VibrasticLab/pikoakustik2/README.md

# Pikoakustik V2

This is audiometri tool project (still in heavy development).
Main chip are STM32F4 and Audio-DAC MAX98357A.

If need previous works, see here: [Pikoakustik](https://github.com/VibrasticLab/pikoakustik)
