VibrasticLab/pikoakustik2/actual/P3_v2.md

# Catatan Desain

## Rekomendasi Revisi PCB P3
- STM32 tanpa resistor pull-up pada jalur SWD-IO
- STM32 USB-CDC pindah resistor pull-up dari jalur DM ke jalur DP
- ESP32 header programming cukup RX0, TX0, dan GND
- Cari pengganti Slot MMC yang serupa dan kompatibel
- STM32 USB-CDC ditambahkan ESD Protection
- STM32 RX (PA10) tidak boleh ada resistor pull-up
- STM32 MMC NSS tidak perlu ada resistor pull-up
- STM32 BOOT-0 dan BOOT-1 pake resistor pull-down
- STM32 tidak pakai (DNP) debouncing capacitor di tombol-tombol
- STM32 tambah header untuk UART
- Ada header terhubung ke
    + ESP32 TX1 -- STM32 RX1
    + ESP32 RX1 -- STM32 TX1
    + ESP32 GND -- STM32 GND
- Smaller Push-Button:
    + STM32 Reset
    + ESP32 Flash
    + ESP32 Reset
- Charging process status/indicator/detection
- ESP32 IO-12 should be low during boot via 0 ohm
- ESP32 IO-15 can be low to prevent boot message (pake dipswitch?)

## Rekomendasi Revisi Casing P3
- Tombol A/B/C masih bergoyang
- Panel LED akan menutup nyala LED jika matahari terang
- Topi tombol SPDT/Power tidak dapat dipasang
- Perlu 3D Print Medical Grade
