VibrasticLab/pikoakustik2/prototrial/dokumen/diskusi_xirca/diskusi_xirca.tex

\documentclass[table,dvipsnames]{beamer}
\mode<presentation>{
    \usetheme{Madrid}
    \setbeamercolor{title}{fg=Black,bg=Blue!15}
    \setbeamercolor{frametitle}{fg=Black,bg=Blue!15}
    \setbeamercolor{block title}{fg=Black,bg=Blue!15}
    \setbeamercolor{block}{fg=Black,bg=Blue!10}
}

\usepackage{hyperref}
\hypersetup{
    colorlinks=true,
    linkcolor=blue,
    filecolor=magenta,
    urlcolor=cyan,
}

\usepackage[normalem]{ulem}
\usepackage{graphicx}
\usepackage{booktabs}
\usepackage{xcolor}
\usepackage{multirow}
\usepackage{minted}
\usepackage[
type={CC},
modifier={by-sa},
version={4.0},
]{doclicense}

\definecolor{LightGray}{gray}{0.9}

\title[Xirca042022]{Activity Report: Xirca Februari 2023}
\author{}
\institute[VibrasticLab : \ccbysa]{
    Achmadi ST MT
}
\date{}

\begin{document}
    \begin{frame}
        \titlepage
    \end{frame}

    \section{Tempat dan Jadwal}
    \begin{frame}
        \begin{exampleblock}{Tempat dan Jadwal}
            Kegiatan berlangsung di:
            \begin{itemize}
                \item Tanggal: 6 Februari 2023 hingga 10 Februari 2023
                \item Pukul: 09:00 WIB hingga 17:00 WIB
                \item Tempat: Gedung Research and Development PT. Xirca Dama Persada\\
                Kompleks Puri Syailendra.\\
                Jl. Lemah Neundeut No. Kav-30, Sukawarna, Setrasari, Kota Bandung, Jawa Barat 40164 .
            \end{itemize}
        \end{exampleblock}
    \end{frame}

    \section{Pembahasan Revisi: Senin 6 Februari 2023}
    \begin{exampleblock}{Casing}
        Pembahasan casing untuk pengajuan BPFK:
        \begin{itemize}
            \item Wiggly/Uncomfortable Buttons
            \item Panel LED warna putih jadi problem ketika cahaya terang
            \item Tombol Power SPDT nya gak masuk
            \item Material kurang medical grade
        \end{itemize}
    \end{exampleblock}

    \begin{exampleblock}{Hasil Diskusi}

    \end{exampleblock}

    \section{Pembahasan Persiapan BPFK}
    \begin{exampleblock}{}

    \end{exampleblock}

\end{document}
