VibrasticLab/pikoakustik2/prototrial/dokumen/prototype_improvement/improve.tex

\documentclass{book} % Definisi jenis dokumen

%%%%% Definisi paket-paket yang seharusnya digunakan %%%%%
\usepackage[utf8]{inputenc} % paket encoding input utf8
\usepackage[T1]{fontenc} % paket encoding huruf latin
\usepackage{tocbibind} % paket toc terdaftar dalam toc

%%%%% Definisi paket-paket yang digunakan sesuai kebutuhan %%%%%
\usepackage[yyyymmdd,hhmmss]{datetime} % paket tanggal-waktu
\usepackage{geometry} % paket ukuran kertas dan margin
\usepackage{graphicx} % paket grafik/gambar
\usepackage{subcaption} % paket untuk subfigure
\usepackage{minted} % paket untuk source code
\usepackage{xcolor} % paket buat warna
\usepackage{hyperref} % paket buat link-link an

%%%%% Pengaturan ukuran kertas dan margin %%%%%
\geometry{
    a4paper,
    left=10mm,
    right=10mm,
    top=15mm,
    bottom=15mm,
}

%%%%% Pengaturan perintah informasi perangkat lunak (hanya untuk GNU/Linux) %%%%%
\newcommand{\ShowOsVersion}{
    \immediate\write18{\unexpanded{foo=`uname -sro` && echo "${foo}" > tmp.tex}}
    \input{tmp}\immediate\write18{rm tmp.tex}
}

\newcommand{\ShowTexVersion}{
    \immediate\write18{\unexpanded{foo=`pdflatex -version | head -n1 | cut -d' ' -f1,2` && echo "${foo}" > tmp.tex}}
    \input{tmp}\immediate\write18{rm tmp.tex}
}

\definecolor{LightGray}{gray}{0.95}

\begin{document}

    %%%%%%%%%%%%%%%%%%%%%%%%%%%%%%%%%%%%%%%%%%%%%%%%%%%%%%%%%%%%%%%%%

    \frontmatter % untuk halaman cover

    \begin{titlepage}

        \centering % untuk membuat tengah teks

        {
            \LARGE % pakai font besar
            \bf % pakai font BOLD
            Rangkuman Improvement Prototype P2 dan P3
        }

        \bigskip
        {\Large \bf Achmadi ST MT}
        \vfill % menambahkan ruang kosong vertikal

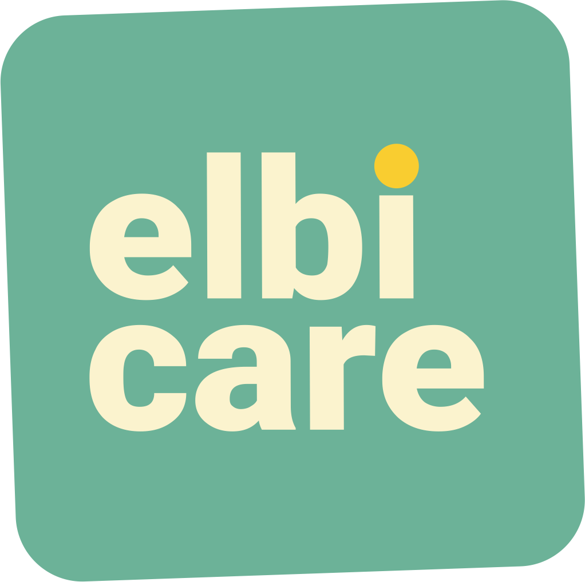
[picture p50: prototrial/dokumen/prototype_improvement/images/elbicare-logo.png]
        
        \vfill

        \raggedright
        \noindent Dokumen ini ditulis dengan:\\ % tanda \\ menambahkan garis baru
        OS : \ShowOsVersion \\
        TeX : \ShowTexVersion \\
        Update: {\today} at \currenttime\\
    \end{titlepage}

	%%%%%%%%%%%%%%%%%%%%%%%%%%%%%%%%%%%%%%%%%%%%%%%%%%%%%%%%%%%%%%%%%
	
	\newpage % halaman baru
	\tableofcontents % daftar isi
	\listoffigures % daftar gambar
	\listoftables % daftar table

    %%%%%%%%%%%%%%%%%%%%%%%%%%%%%%%%%%%%%%%%%%%%%%%%%%%%%%%%%%%%%%%%%
    
    \mainmatter % pindah format halaman dari romawi ke angka (konten utama)
    
    \newpage
    \chapter{Definisi}
    
    Berikut beberapa definisi umum yang digunakan dalam dokumen ini:
    
    \begin{enumerate}
    	\item \textbf{P2}: Mengacu pada desain Prototype Versi 2 yang 
    	dikembangkan selama awal tahun 2021 sebagai acuan awal desain produk
    	
    	\begin{figure}[!ht]
    		\centering
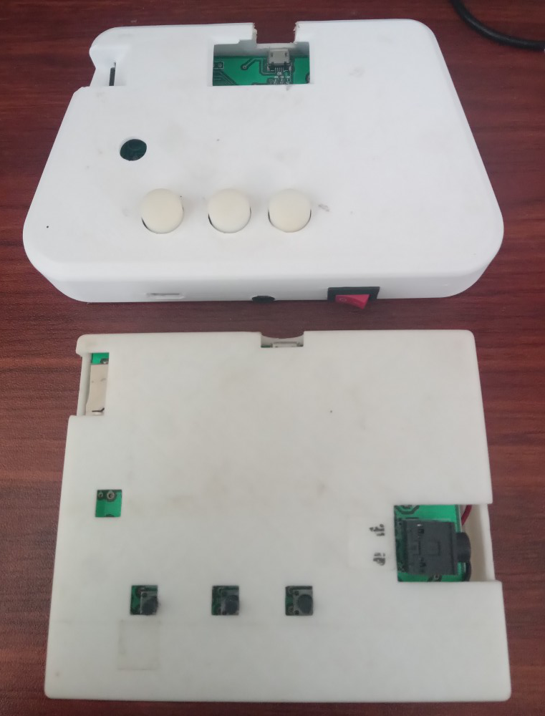
[picture p51: prototrial/dokumen/prototype_improvement/images/p2.jpg]
    		
    		\caption{Gambaran Unit P2 (kanan) dan Unit P2 dengan improvisasi 
    		casing (kiri)}
    	\end{figure}
    
    	\item \textbf{P3}: Mengacu pada desain Prototype Versi 3 yang 
    	dikembangkan sejak akhir tahun 2021 sebagai desain produk siap produksi 
    	massal
    	
    	\begin{figure}[!ht]
    		\centering
    		
    		\caption{Gambaran Unit P3}
    	\end{figure}
    \end{enumerate}
    
    \newpage
    \chapter{Circuit}
    
    Berikut dirangkum perbaikan produk di aspek desain sirkuit elektronik 
    tercetak (PCB), yang dibagi dalam grup-grup komponen.
    
    \section{STM32}
    
    Untuk penggunaan chip utama Audiometri, yaitu STM32 ARM Cortex-M4, tidak 
    mengalami perubahan jauh.
    
    \begin{figure}[!ht]
    	\centering
    	\begin{subfigure}[t]{0.25\textwidth}
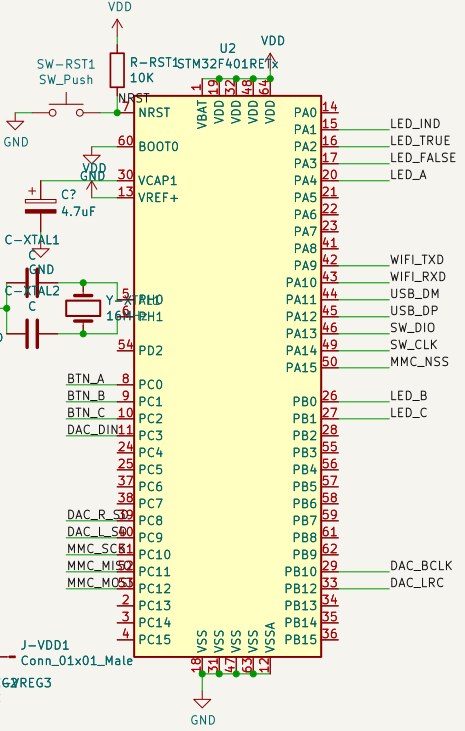
[picture p52: prototrial/dokumen/prototype_improvement/images/p2_stm32.png]
    		
    		\caption{STM32 pada P2}
    	\end{subfigure}
    	\begin{subfigure}[t]{0.40\textwidth}
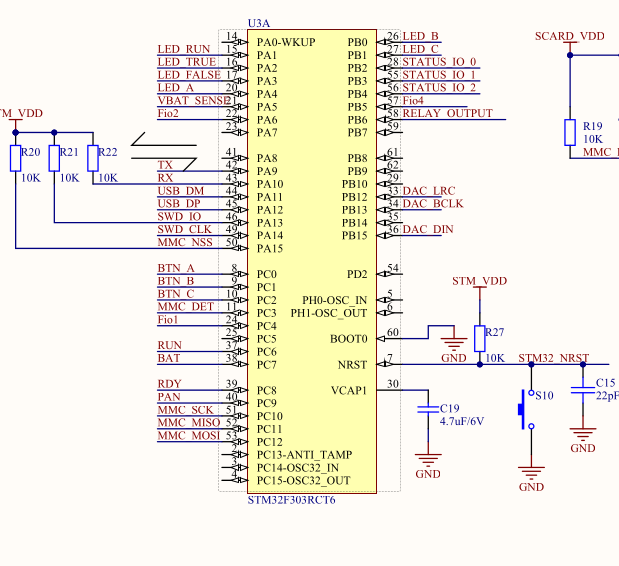
[picture p53: prototrial/dokumen/prototype_improvement/images/p3_stm32.png]
    		
    		\caption{STM32 pada P3}
    	\end{subfigure}
    	\caption{STM32 sebagai chip Audiometri}
    \end{figure}

	Beberapa poin rangkuman perbaikan:
	\begin{itemize}
		\item Kompatibel dengan chip STM32 ARM Cortex-M4 untuk paket LQFP64.
		Chip yang telah digunakan adalah STM32F401RET6 dan STM32F303RBT6
		
		\item External RC/Crystal source dihapus
		
		\item Tambahan pull-up resistor pada beberapa pin.
		Beberapa catatan terkait pull-up resistor untuk desain selanjutnya:
		\begin{itemize}
			\item SWD-IO tidak boleh ada pull-up
			\item Pull pada USB-DM harus dipindah ke USB-DP
		\end{itemize}
	\end{itemize}

	Chip STM32 Cortex-M4 ini yang menangani proses \textit{3-Force Choice} (3FC) ,
	pembuatan sinyal PCM untuk nada murni, serta olah data hasil Audiometri via USB-Serial.
    
    \section{ESP32}
    
    Penambahan modul ESP32 (ESP-WROOM-32) adalah fitur baru yang sebelumnya 
    tidak ada pada P2.
    Modul ini ditambahkan sebagai penunjang antar muka pengguna dalam penggunaan 
    Audiometri yang ditangani oleh chip STM32
    
    \begin{figure}[!ht]
    	\centering
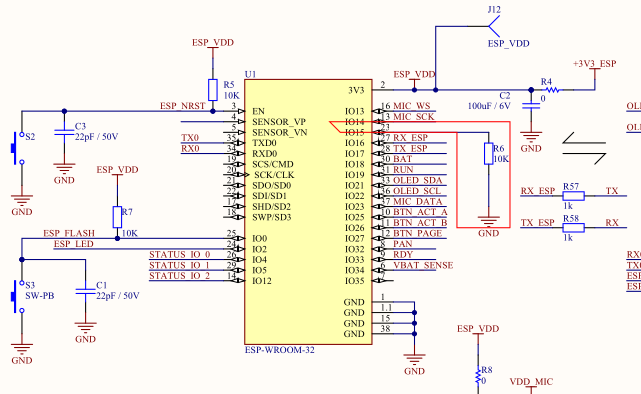
[picture p54: prototrial/dokumen/prototype_improvement/images/p3_esp32.png]
    	
    	\caption{Modul ESP32 pada P3}
    \end{figure}
	
	\newpage
	Fitur yang akan ditangani oleh modul ESP32 meliputi:
	\begin{itemize}
		\item \textit{Drawing} untuk tampilan layar dan data ke pengguna
		\item Komunikasi data dengan server untuk wadah data pengguna via WiFi Station
		\item Pengaturan unit via WiFi Access Point
		\item Memantau besar derau audio lingkungan
		\item Memantau status fitur-fitur pada unit
	\end{itemize}
    
    \section{Power}
    
    Untuk bagian pengaturan daya, telah mengalami perbaikan sangat signifikan sehingga desain P3 menjadi lebih stabil.
    
    \begin{figure}[!ht]
    	\centering
    	\begin{subfigure}[t]{0.25\textwidth}
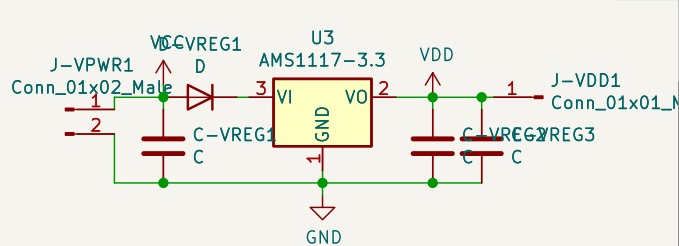
[picture p55: prototrial/dokumen/prototype_improvement/images/p2_vreg.png]
    		
    		\caption{Power Regulator pada P2}
    	\end{subfigure}
    	\begin{subfigure}[t]{0.40\textwidth}
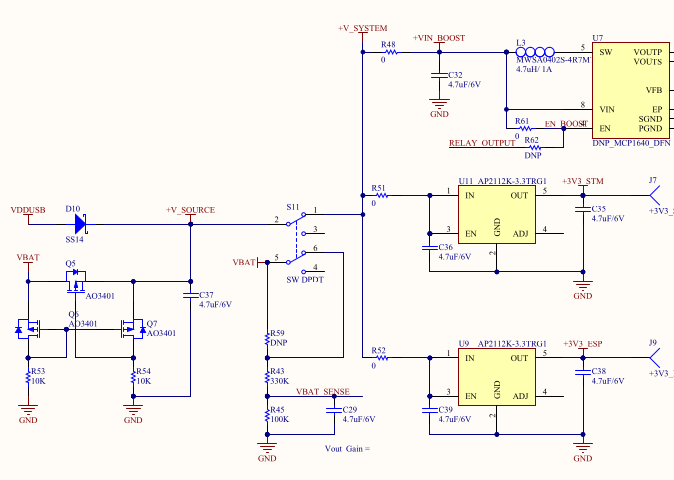
[picture p56: prototrial/dokumen/prototype_improvement/images/p3_vreg.png]
    		
    		\caption{Power Regulator pada P3}
    	\end{subfigure}
    	\caption{Power Regulator}
    \end{figure}

	Beberapa poin rangkuman perbaikan antara lain:
	\begin{itemize}
		\item Regulator utama diganti dari berbasis AMS1117 LDO 3v3 menjadi AP2112K 3v3.
		\item Pemisahan regulator daya menjadi beberapa grup sesuai kebutuhan
	\end{itemize}
    
    \section{Audio DAC}
    
    Untuk bagian Audio yang menghasilkan nada murni, chip yang digunakan tetap MAX98357A.
    Namun mendapat perubahan desain terkait pengaturan channel kiri dan kanan.
    
    \begin{figure}[!ht]
    	\centering
    	\begin{subfigure}[t]{0.25\textwidth}
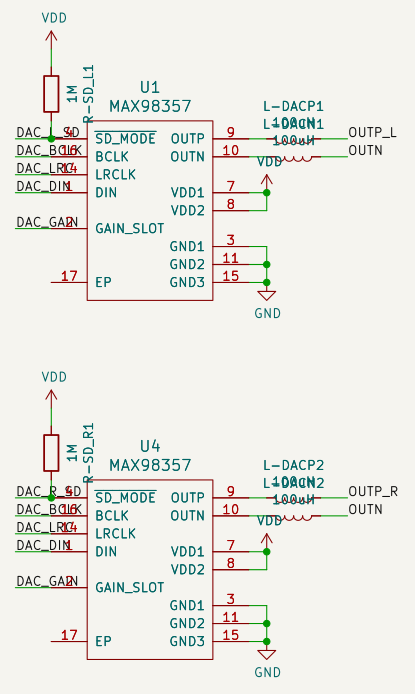
[picture p57: prototrial/dokumen/prototype_improvement/images/p2_dac.png]
    		
    		\caption{Audio DAC pada P2}
    	\end{subfigure}
    	\begin{subfigure}[t]{0.60\textwidth}
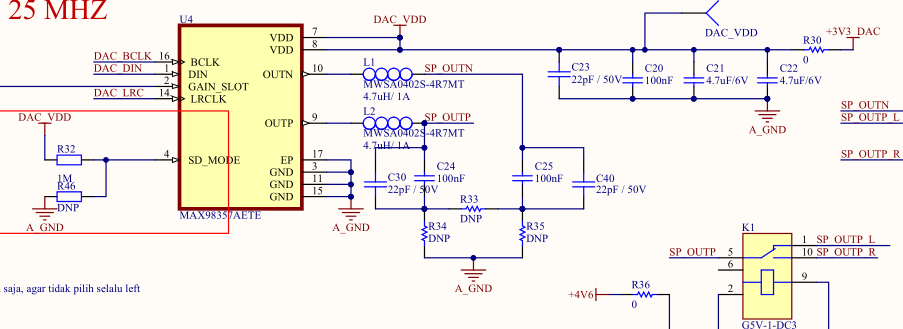
[picture p58: prototrial/dokumen/prototype_improvement/images/p3_dac.png]
    		
    		\caption{Audio DAC pada P3}
    	\end{subfigure}
    	\caption{Audio DAC}
    \end{figure}

	Beberapa poin rangkuman perbaikan antara lain:
	\begin{itemize}
		\item Audio DAC menggunakan relay sebagai pemisah channel, bukan lagi 2 chip tersendiri
		\item Tambahan banyak decoupling capacitor dan filter pada output
		\item Mendapat regulator tenaga tersendiri (terpisah dengan chip/modul utama lain)
	\end{itemize}
    
    \section{Display}
    
    P3 mendapat fitur baru berupa OLED LCD untuk membantu pengguna.
    OLED LCD yang digunakan berupa 128x64 LCD yang terhubung ke modul ESP32 melalui jalur I2C.
    
    \begin{figure}[!ht]
    	\centering
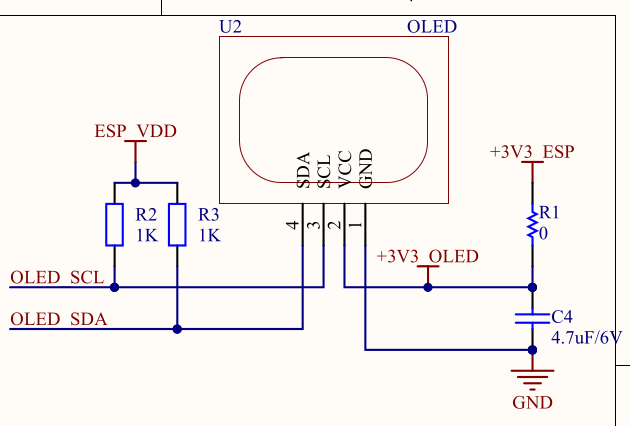
[picture p59: prototrial/dokumen/prototype_improvement/images/p3_oled.png]
    	
    	\caption{Modul OLED LCD}
    \end{figure}
    
    \newpage
    \section{Storage}
    
    Untuk penyimpanan hasil Audiometri, baik P2 dan P3 sama-sama menggunakan MicroSD yang
    terhubung dengan STM32 melalui jalur SPI.
    
    \begin{figure}[!ht]
    	\centering
    	\begin{subfigure}[t]{0.25\textwidth}
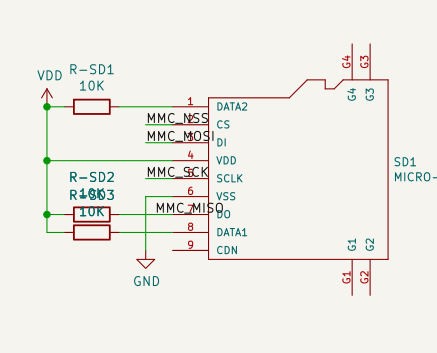
[picture p60: prototrial/dokumen/prototype_improvement/images/p2_mmc.png]
    		
    		\caption{MMC pada P2}
    	\end{subfigure}
    	\begin{subfigure}[t]{0.60\textwidth}
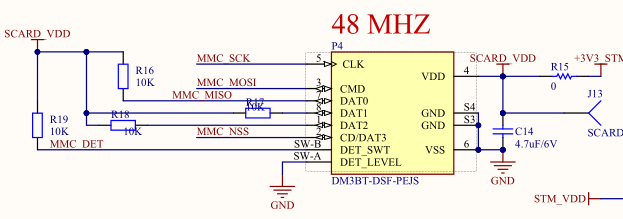
[picture p61: prototrial/dokumen/prototype_improvement/images/p3_mmc.png]
    		
    		\caption{MMC pada P3}
    	\end{subfigure}
    	\caption{Slot MMC}
    \end{figure}

	Beberapa poin rangkuman perbaikan antara lain:
	\begin{itemize}
		\item Slot diganti ke pinout kompatibel DM3BT.
		\item Pin deteksi diaktifkan dengan tambahan pull-up resistor.
	\end{itemize}

	Catatan: Diperlukan beberapa purchasing komponen slot MMC yang kompatibel DM3BT.
    
    \section{USB-Data}
    
    Untuk USB-CDC sebagai antar-muka data, tidak mengalami banyak perubahan.
    USB-CDC tetap terhubung ke pin USB dari STM32.
    
    \begin{figure}[!ht]
    	\centering
    	\begin{subfigure}[t]{0.4\textwidth}
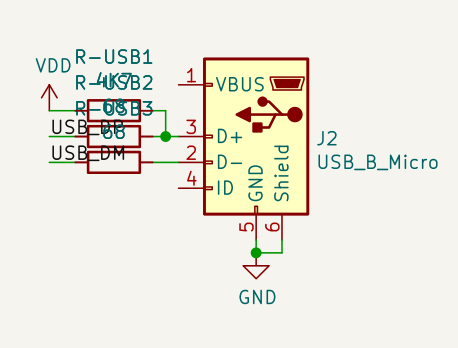
[picture p62: prototrial/dokumen/prototype_improvement/images/p2_usb.png]
    		
    		\caption{USB-CDC pada P2}
    	\end{subfigure}
    	\begin{subfigure}[t]{0.4\textwidth}
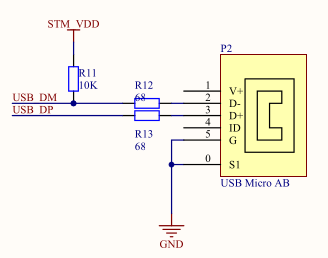
[picture p63: prototrial/dokumen/prototype_improvement/images/p3_usb.png]
    		
    		\caption{USB-CDC pada P3}
    	\end{subfigure}
    	\caption{USB-CDC}
    \end{figure}

	Catatan: Disarankan ditambahkan USB ESD Protection.
    
    \newpage
    \section{Microphone}
    
    Untuk P3, ditambahkan fitur Microphone berbasis INMP441 yang terhubung ke ESP32 melalui jalur I2S.
    Microphone ini akan digunakan untuk membantu memantau derau lingkungan saat proses Audiometri.
    
    \begin{figure}[!ht]
    	\centering
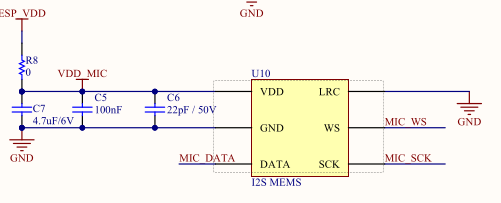
[picture p64: prototrial/dokumen/prototype_improvement/images/p3_mic.png]
    	
    	\caption{Microphone}
    \end{figure}
    
    \chapter{Casing}
    
    Untuk bagian Casing, berikut penjabaran singkat perbandingan casing antara unit P2 dan P3
    Secara umum, casing P2 lebih sederhana dan tidak memiliki antara muka tombol user dan LCD OLED.
    Bentuk casing masih balok sederhana yang hanya "menyelimuti" PCB dan battery.
    
    \begin{figure}[!ht]
    	\centering
    	\begin{subfigure}[t]{0.45\textwidth}
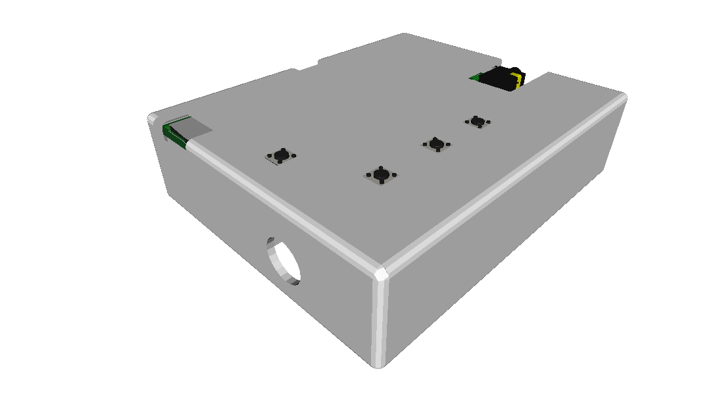
[picture p65: prototrial/dokumen/prototype_improvement/images/p2_ortho_top.png]
    		
    		\caption{Tampilan Orthogonal Atas}
    	\end{subfigure}
    	\begin{subfigure}[t]{0.45\textwidth}
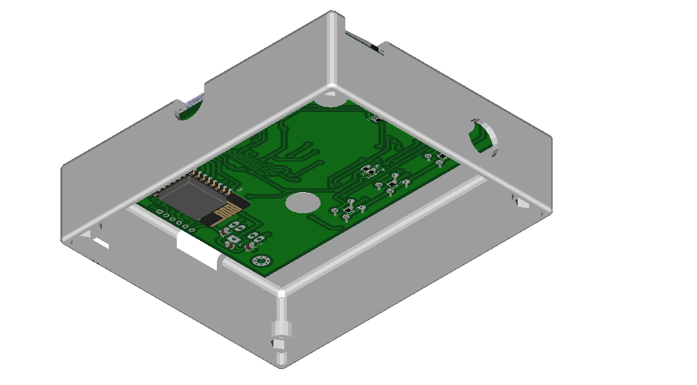
[picture p66: prototrial/dokumen/prototype_improvement/images/p2_ortho_bot.png]
    		
    		\caption{Tampilan Orthogonal Bawah}
    	\end{subfigure}
    	\caption{Tampilan Casing P2}
    \end{figure}

	\begin{figure}[!ht]
		\centering
		\begin{subfigure}[t]{0.45\textwidth}
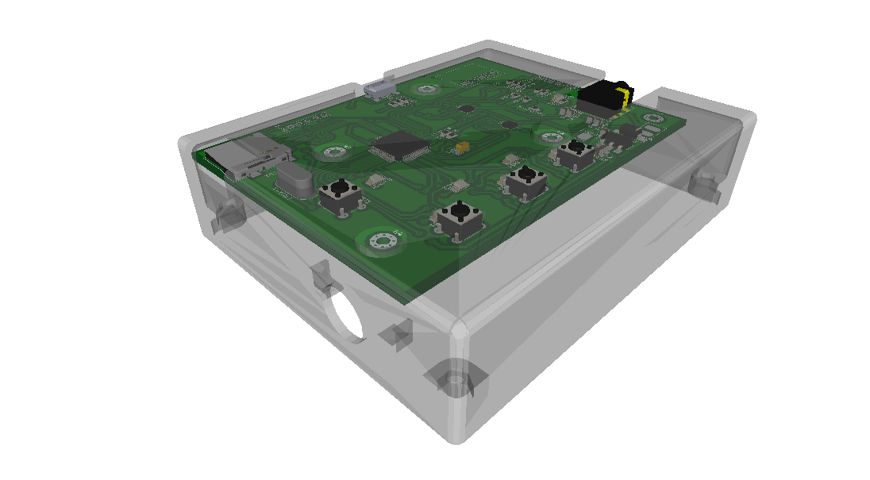
[picture p67: prototrial/dokumen/prototype_improvement/images/p2_ortho_top_trans.png]
			
			\caption{Tampilan Orthogonal Atas}
		\end{subfigure}
		\begin{subfigure}[t]{0.45\textwidth}
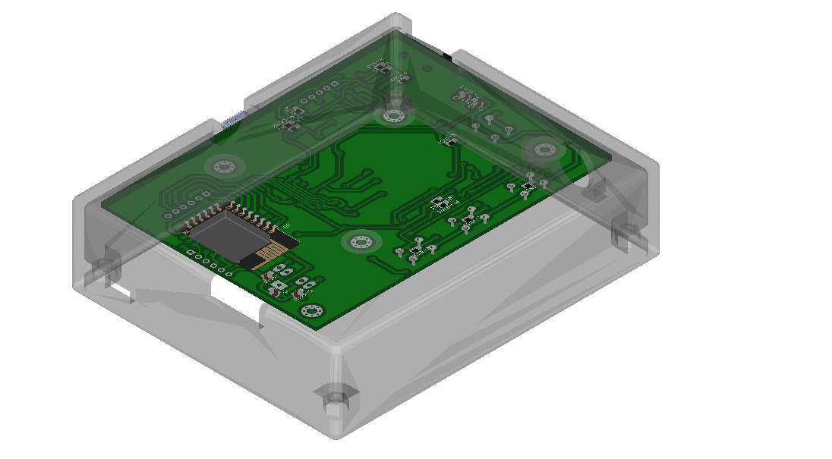
[picture p68: prototrial/dokumen/prototype_improvement/images/p2_ortho_bot_trans.png]
			
			\caption{Tampilan Orthogonal Bawah}
		\end{subfigure}
		\caption{Tampilan Casing P2 dengan tampak PCB}
	\end{figure}

	Untuk casing P3 telah mendapat improvisasi signifikan, antara lain:
	\begin{itemize}
		\item Outline PCB didesain menyesuaikan outline casing, sehingga dapat lebih pas.
		
		\item Port Audio, USB, dan MMC dipindahkan ke atas dan bawah, sehingga sisa kanan dan kiri
		dapat sepenuhnya untuk telapak tangan.
		
		\item Tambahan slot untuk tombol user dan layar LCD OLED.
		
		\item Kontur fisik casing mengikuti ergonomi (tidak berupa balok sederhana)
	\end{itemize}

	\newpage
	Berikut tampilan casing P3
	
	\begin{figure}[!ht]
		\centering
		\begin{subfigure}[t]{0.45\textwidth}
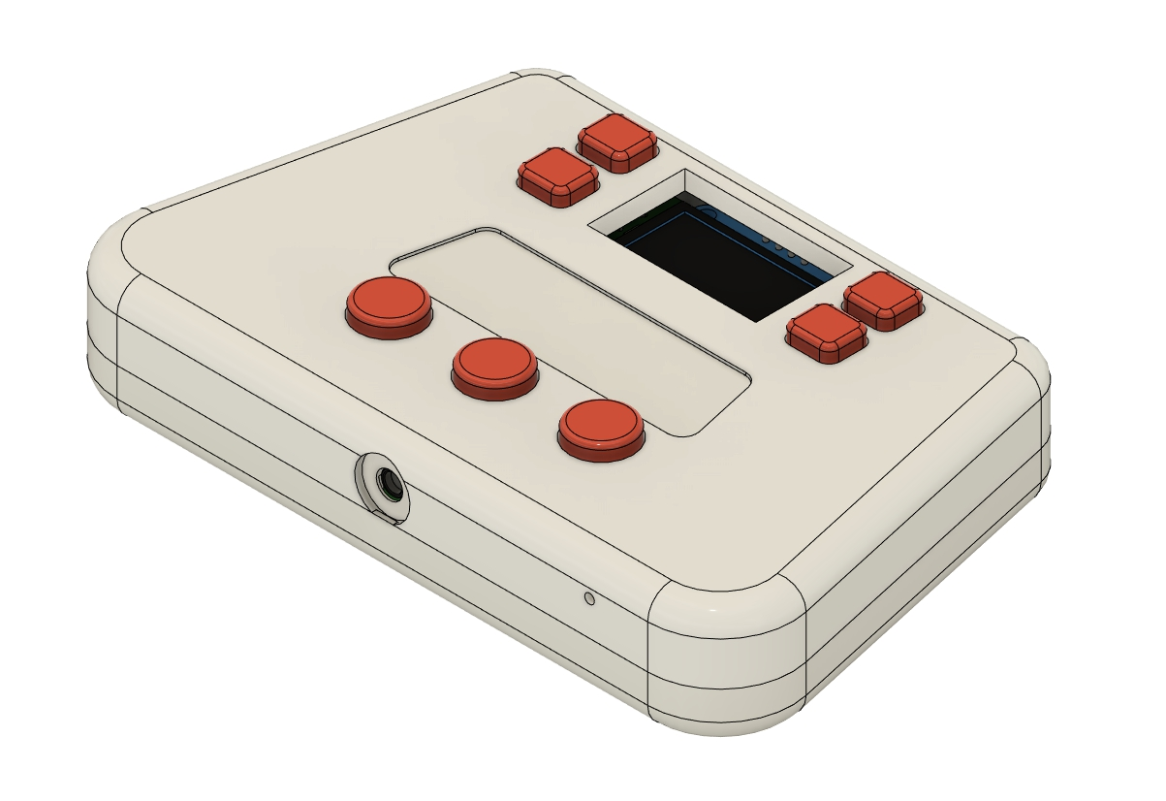
[picture p69: prototrial/dokumen/prototype_improvement/images/p3_casing_outline.png]
			
			\caption{Tampilan Outline}
		\end{subfigure}
		\begin{subfigure}[t]{0.45\textwidth}
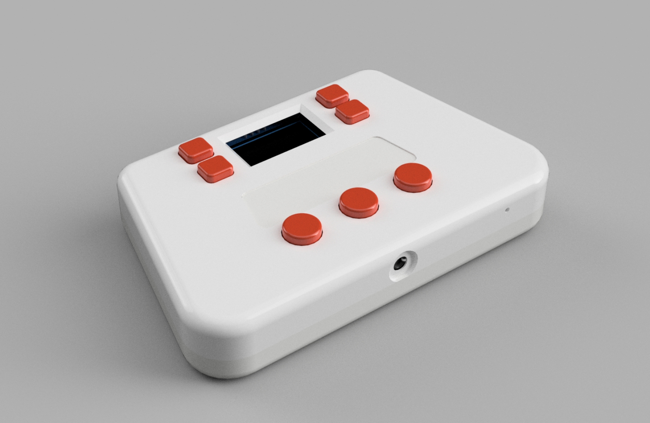
[picture p70: prototrial/dokumen/prototype_improvement/images/p3_casing.png]
			
			\caption{Tampilan 3D}
		\end{subfigure}
		\caption{Tampilan Casing P3}
	\end{figure}

	\begin{figure}[!ht]
		\centering
		\begin{subfigure}[t]{0.45\textwidth}
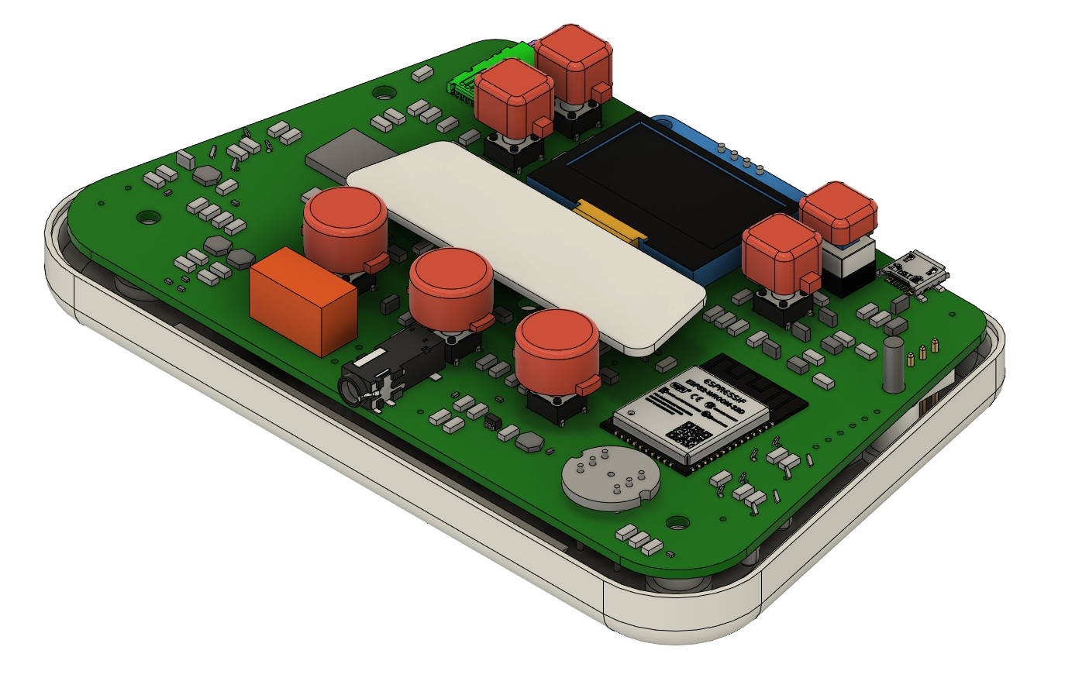
[picture p71: prototrial/dokumen/prototype_improvement/images/p3_casing_pcb.png]
			
			\caption{Tampilan Outline dengan PCB}
		\end{subfigure}
		\begin{subfigure}[t]{0.45\textwidth}
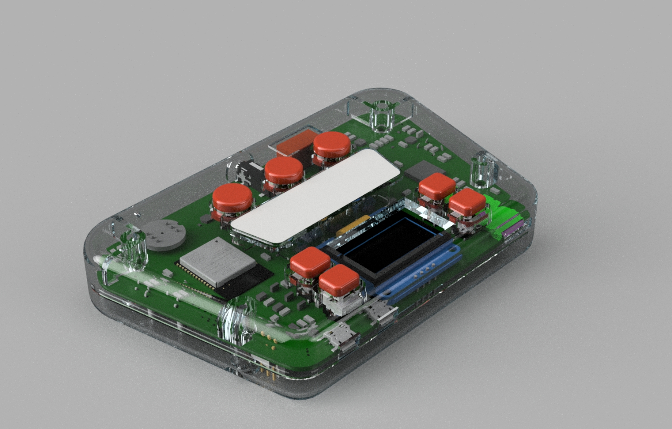
[picture p72: prototrial/dokumen/prototype_improvement/images/p3_casing_trans.png]
			
			\caption{Tampilan 3D dengan PCB}
		\end{subfigure}
		\caption{Tampilan Casing P3 dan PCB}
	\end{figure}
    
    \chapter{Firmware}
    
    Berikut dijabarkan singkat beberapa upgrade esensial pada programm di dalam chip (firmware).
    
    \section{Komunikasi chip STM32 dan ESP32}
    
    Berikut potongan kode yang membangun komunikasi antar chip:
    
    \begin{minted}[frame=lines,framesep=2mm,fontsize=\small,bgcolor=LightGray]{c}
#if USER_ESP32
static void cmd_esp(BaseSequentialStream *chp, int argc, char *argv[]) {
	if(argc!=1){
		chprintf(chp,"Usage: esp [wifi]\r\n");
		return;
	}
	
	if(strcmp(argv[0],"wifi")==0){
		ht_commUSB_Msg("wifi 1\r\n");
		ht_commUART_Msg("wifi 1\r\n");
	}
	
}
#endif
    \end{minted}

	Catatan commit dapat dilihat pada tautan berikut: \\
	\url{https://github.com/VibrasticLab/pikoakustik2/commit/1fb3d2bbe1bf70bc83f9fc04626da6788534853a}
	
	\section{Status GPIO}
	
	Berikut potongan kode dimana chip ESP32 mengawasi status STM32 melalui nilai logika pin.
	
	\begin{minted}[frame=lines,framesep=2mm,fontsize=\small,bgcolor=LightGray]{c}
#define PIN_STMSTT_READY	33

#define IO_STMSTT_IN ((1ULL<<PIN_STMSTT_READY))

extern uint8_t runIdle;

static void stm32statusTask(void *pvParameter){
	while (1) {
		vTaskDelay(100 / portTICK_PERIOD_MS);
		
		if(gpio_get_level(PIN_STMSTT_READY)==1)runIdle=HT_STATE_IDLE;
		else if(gpio_get_level(PIN_STMSTT_READY)==0)runIdle=HT_STATE_PREP;
	}
}

void msg_htiosttInit(void){
	gpio_config_t stm32iostt_conf;
	
	stm32iostt_conf.intr_type = GPIO_INTR_DISABLE;
	stm32iostt_conf.mode = GPIO_MODE_INPUT;
	stm32iostt_conf.pin_bit_mask = IO_STMSTT_IN;
	stm32iostt_conf.pull_down_en = GPIO_PULLDOWN_ENABLE;
	stm32iostt_conf.pull_up_en = GPIO_PULLUP_DISABLE;
	gpio_config(&stm32iostt_conf);
	
	xTaskCreate(&stm32statusTask, "stm32status_task", 1024, NULL, tskIDLE_PRIORITY, NULL);
}
	\end{minted}

	Catatan commit dapat dilihat pada tautan berikut: \\
	\url{https://github.com/VibrasticLab/pikoakustik2/commit/ea8ad4c23ea734fd0c6e4667258446635624f307}
	
	\section{ESP32 HTTPD}
	
	Disediakan WIFI server untuk membantu pengguna melakukan pengaturan dan operasi unit untuk
	proses yang tidak berkaitan dengan sesi Audiometri langsung
	
	\begin{minted}[frame=lines,framesep=2mm,fontsize=\small,bgcolor=LightGray]{c}
static httpd_handle_t start_webserver(void){
	httpd_handle_t server = NULL;
	httpd_config_t config = HTTPD_DEFAULT_CONFIG();
	config.lru_purge_enable = true;
	
	ESP_LOGI(TAG,"Starting server on port: %d",config.server_port);
	if(httpd_start(&server,&config)==ESP_OK){
		ESP_LOGI(TAG, "Register URI handlers");
		httpd_register_uri_handler(server,&hello);
		return server;
	}
	
	ESP_LOGI(TAG, "Server start error");
	return NULL;
}
	\end{minted}

	Catatan commit dapat dilihat pada tautan berikut: \\
	\url{https://github.com/VibrasticLab/pikoakustik2/commit/0610ab66aaa5b126126c506176e9d01e94bd3d4f}

	\section{Pengawas Battery}
	
	ESP32 melaksanakan tugas pengawasan muatan battery dengan memantau nilai tegangan battery melalui fitur ADC
	yang dimiliki.
	
	\begin{minted}[frame=lines,framesep=2mm,fontsize=\small,bgcolor=LightGray]{c}
void my_adcGetBatt(void){
	int adcVolt;
	int adcVoltRange;
	
	adc_raw[0][0] = adc1_get_raw(ADC1_EXAMPLE_CHAN0);
	battPercent = adc_raw[0][0] * 100 / ADC_REFF_VAL;
	if((adc_raw[0][0]>=ADC_BATT_EMTY) && (adc_raw[0][0]<ADC_BATT_FULL)){
		adcVolt = adc_raw[0][0] - ADC_BATT_EMTY;
		adcVoltRange = ADC_BATT_FULL - ADC_BATT_EMTY;
		battPercent = adcVolt * 100 / adcVoltRange;
	}
	else{
		if(adc_raw[0][0]>=ADC_BATT_FULL) battPercent = 100;
		if(adc_raw[0][0]<ADC_BATT_EMTY) battPercent = 0;
	}
}
	\end{minted}

	Catatan commit dapat dilihat pada tautan berikut: \\
	\url{https://github.com/VibrasticLab/pikoakustik2/commit/43d9589735e2824f7ac6ef5610cf95006735dce6}

\end{document}
