VibrasticLab/pikoakustik2/prototrial/firmware/esp8266/main/oled_urls.md

# ESP8266 RTOS I2C OLED Projects
- https://github.com/Fonger/ESP8266-RTOS-SSD1306
- https://github.com/Fonger/ESP8266-RTOS-FONTS
- https://github.com/yanbe/ssd1306-esp-idf-i2c
- https://github.com/baoshi/ESP-I2C-OLED
- https://github.com/espressif/esp8266-rtos-sample-code
