VibrasticLab/pikoakustik2/prototrial/dokumen/gagal_impor/images/pesan3DIO.jpeg

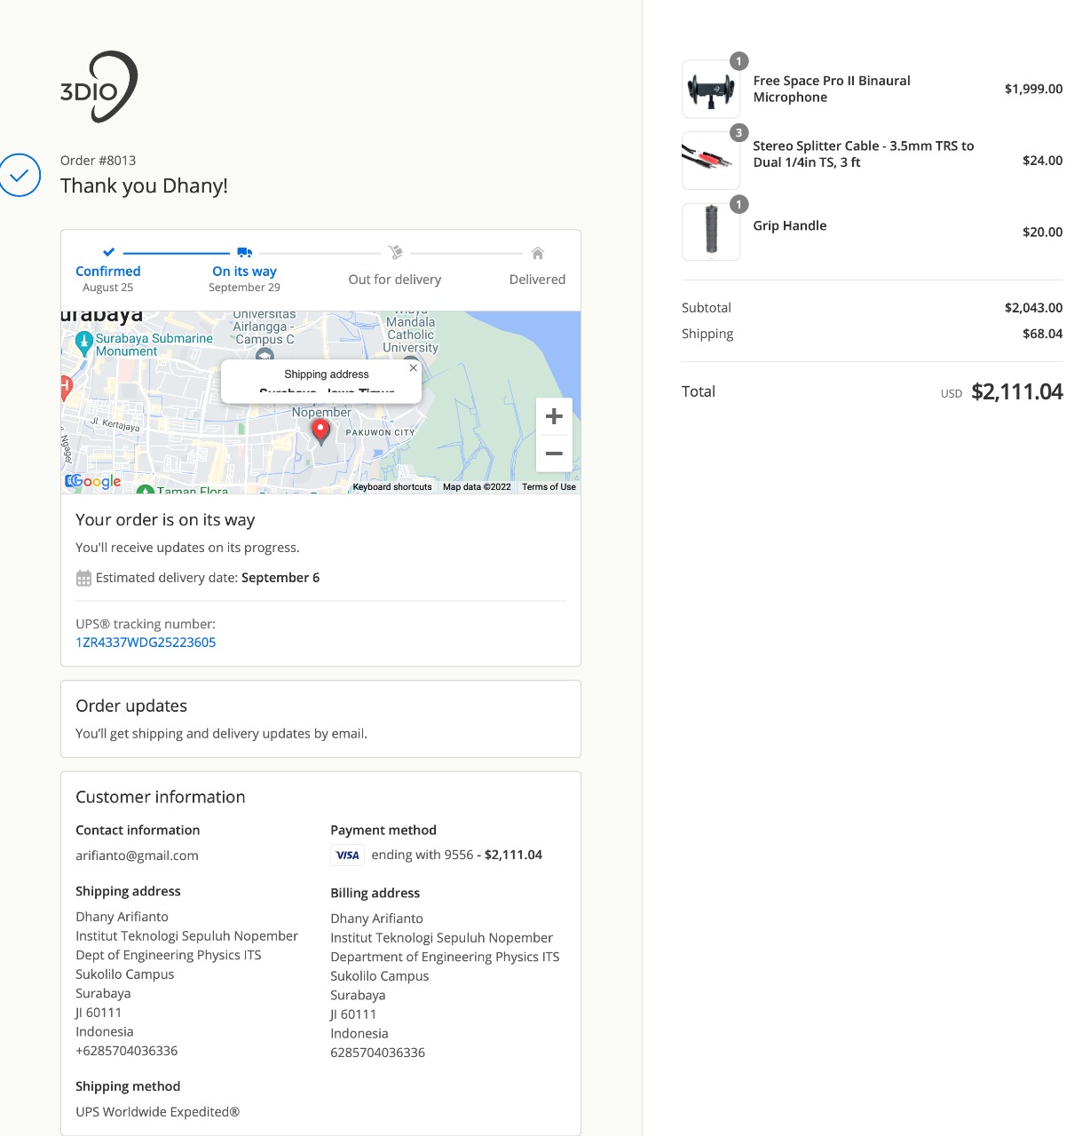
prototrial/dokumen/gagal_impor/images/pesan3DIO.jpeg
