VibrasticLab/pikoakustik2/prototrial/dokumen/specsheet/images/3forcechoice.jpg

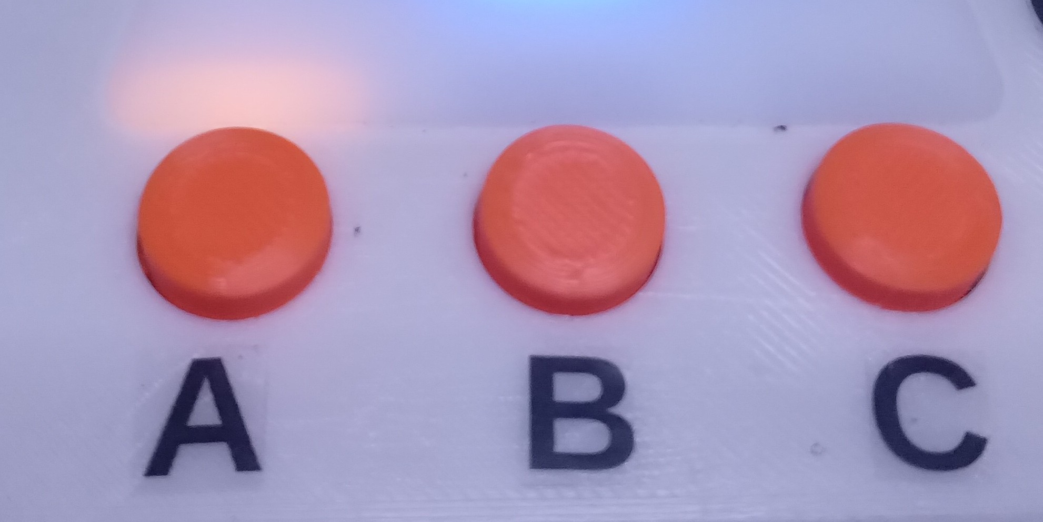
prototrial/dokumen/specsheet/images/3forcechoice.jpg
