VibrasticLab/pikoakustik2/prototrial/dokumen/uji_prototype/images/front-panel.jpeg

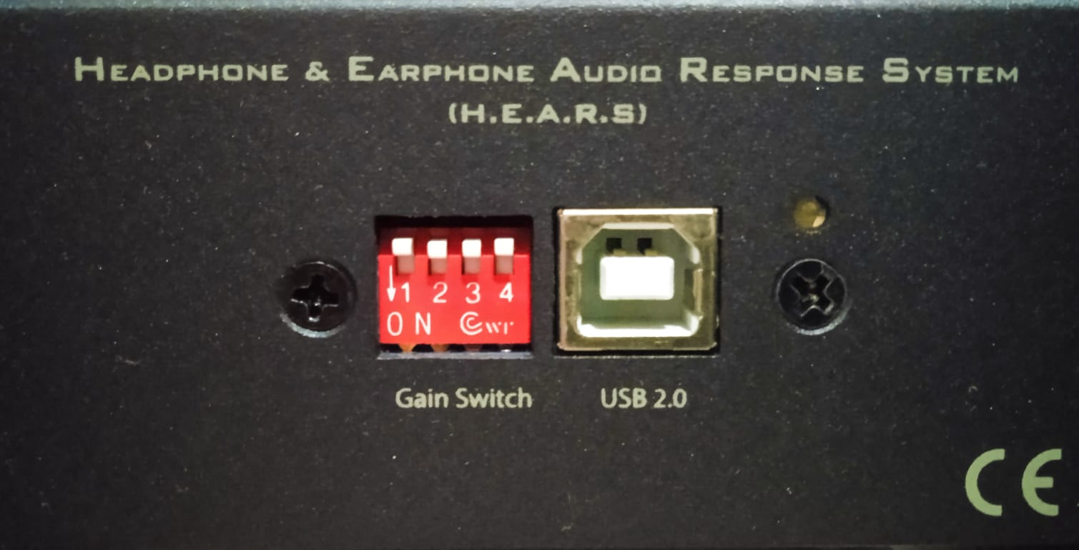
prototrial/dokumen/uji_prototype/images/front-panel.jpeg
