VibrasticLab/pikoakustik2/prototrial/dokumen/uji_prototype/images/headphone-left.jpeg

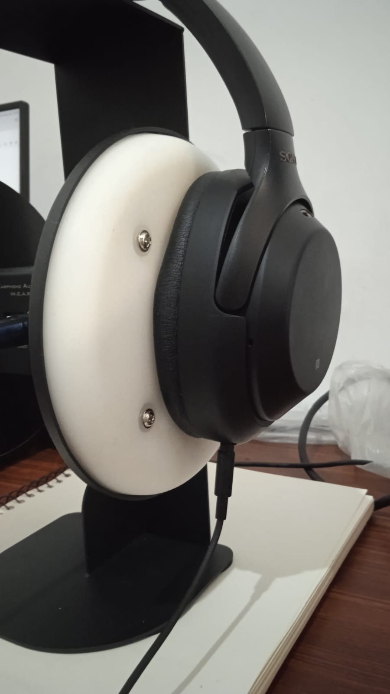
prototrial/dokumen/uji_prototype/images/headphone-left.jpeg
