VibrasticLab/pikoakustik2/prototrial/dokumen/uji_prototype/images/headphone-mounted.jpeg

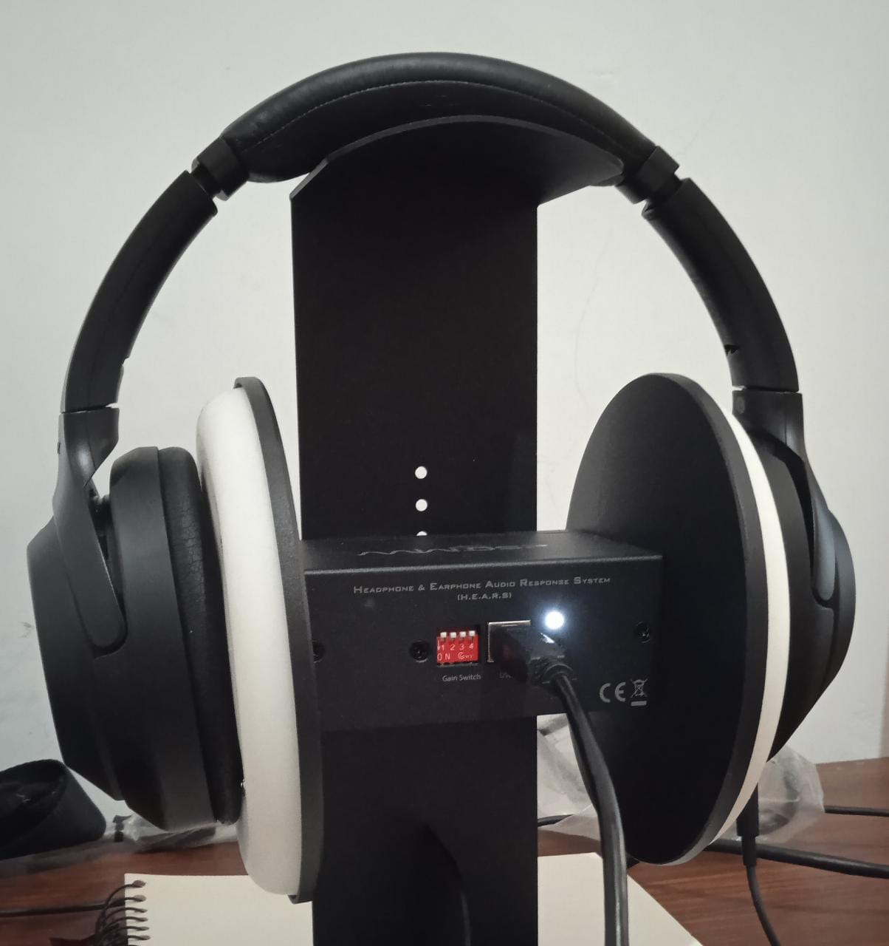
prototrial/dokumen/uji_prototype/images/headphone-mounted.jpeg
