VibrasticLab/pikoakustik2/prototrial/dokumen/uji_prototype/images/headphone-right.jpeg

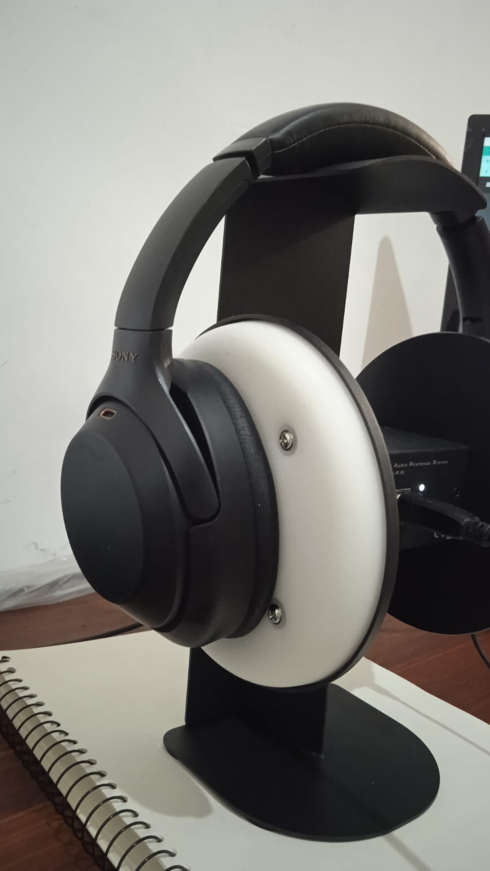
prototrial/dokumen/uji_prototype/images/headphone-right.jpeg
