VibrasticLab/pikoakustik2/prototrial/dokumen/uji_prototype/images/plug-in-audio.jpeg

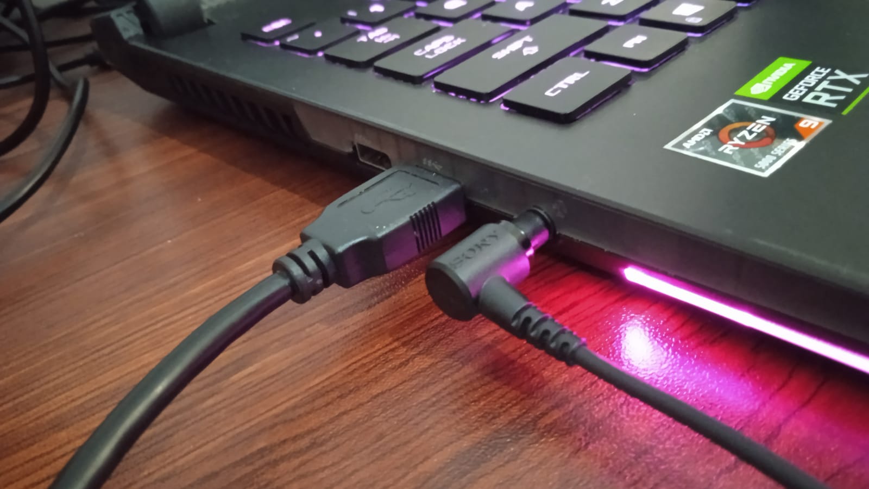
prototrial/dokumen/uji_prototype/images/plug-in-audio.jpeg
