VibrasticLab/pikoakustik2/prototrial/dokumen/uji_prototype/images/plug-in-usb.jpeg

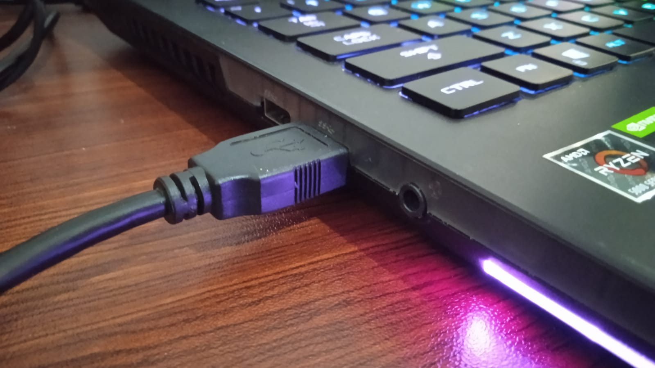
prototrial/dokumen/uji_prototype/images/plug-in-usb.jpeg
