VibrasticLab/pikoakustik2/prototrial/dokumen/uji_prototype/images/plug-in.jpeg

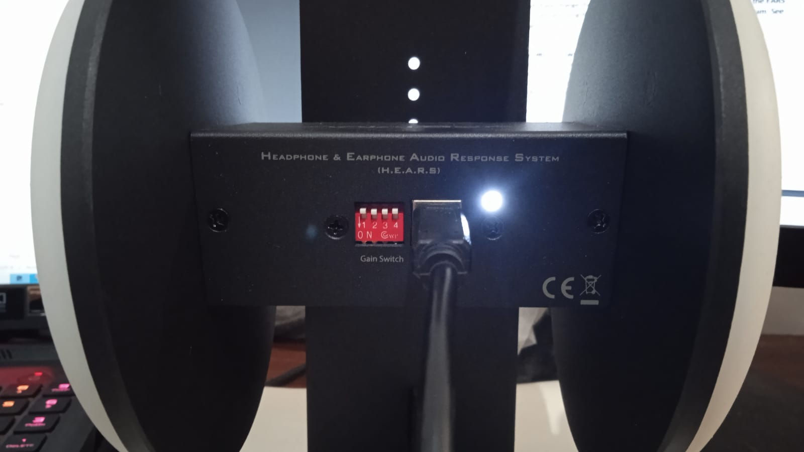
prototrial/dokumen/uji_prototype/images/plug-in.jpeg
