VibrasticLab/pikoakustik2/prototrial/dokumen/specsheet/example/BOM.png

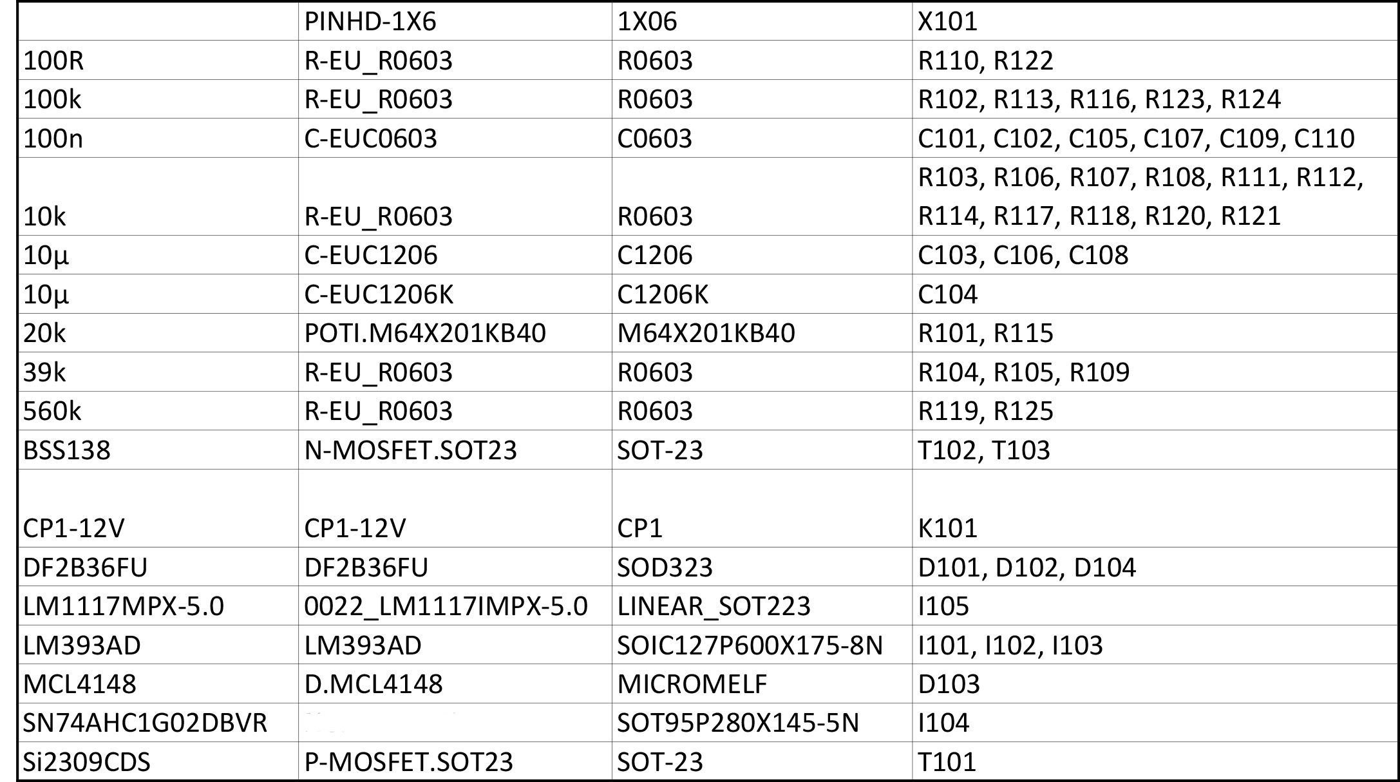
prototrial/dokumen/specsheet/example/BOM.png
