VibrasticLab/pikoakustik2/prototrial/dokumen/activity_report/images/solderclean0.jpg

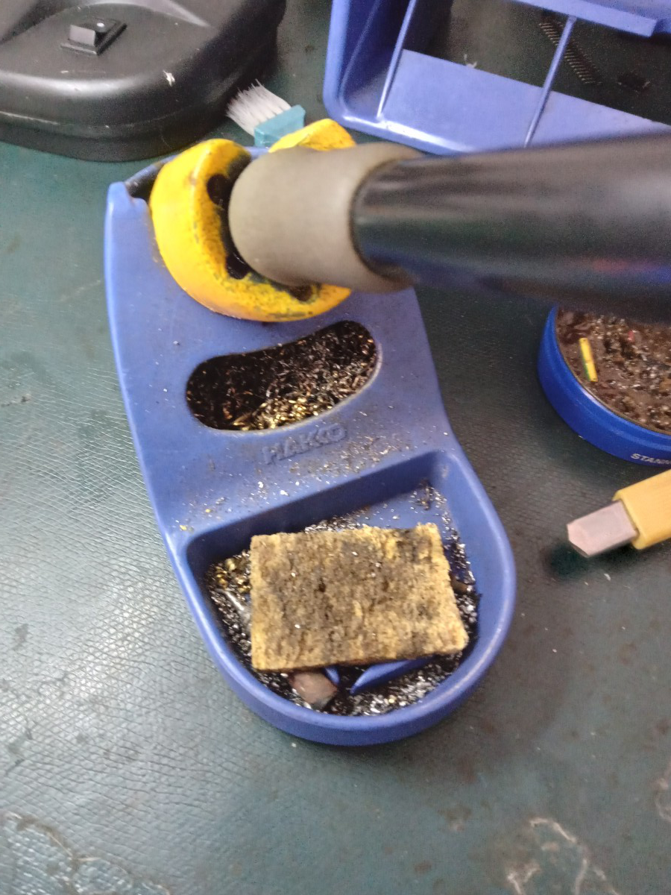
prototrial/dokumen/activity_report/images/solderclean0.jpg
