VibrasticLab/pikoakustik2/prototrial/dokumen/activity_report/images/solderclean1.jpg

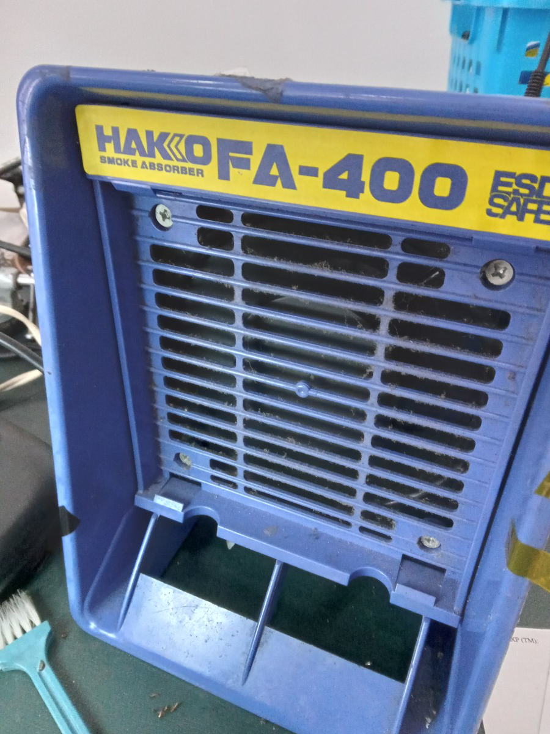
prototrial/dokumen/activity_report/images/solderclean1.jpg
