VibrasticLab/pikoakustik2/prototrial/dokumen/berita_acara/itb_july2023/test_calib/images/kemar_calib_setup.jpg

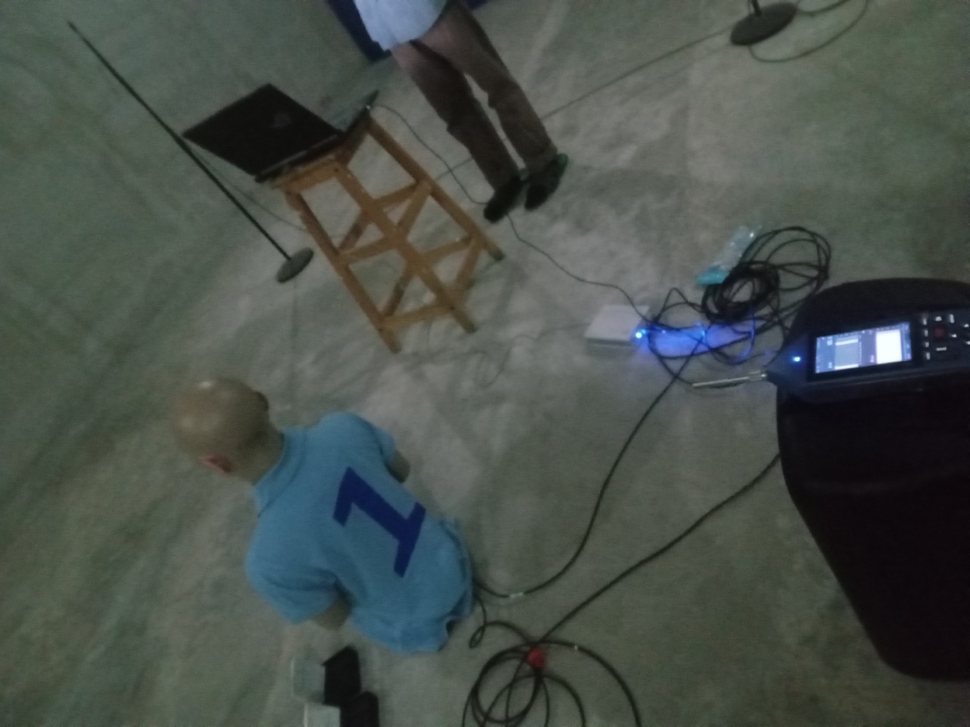
prototrial/dokumen/berita_acara/itb_july2023/test_calib/images/kemar_calib_setup.jpg
