VibrasticLab/pikoakustik2/prototrial/dokumen/blue-print/manual-book/images/atas.jpeg

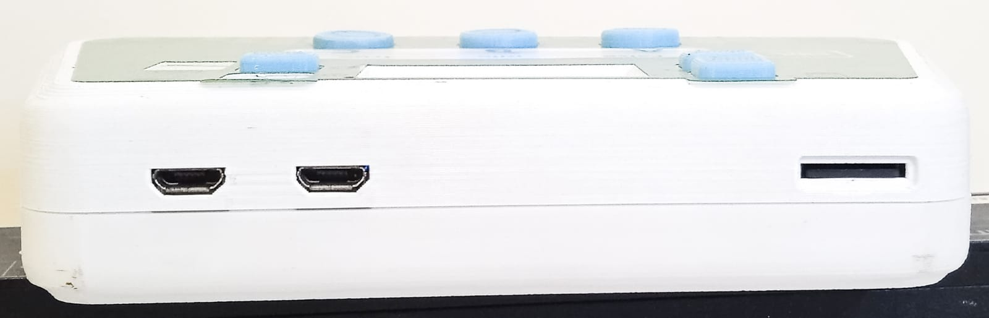
prototrial/dokumen/blue-print/manual-book/images/atas.jpeg
