VibrasticLab/pikoakustik2/prototrial/dokumen/blue-print/manual-book/images/bawah.jpeg

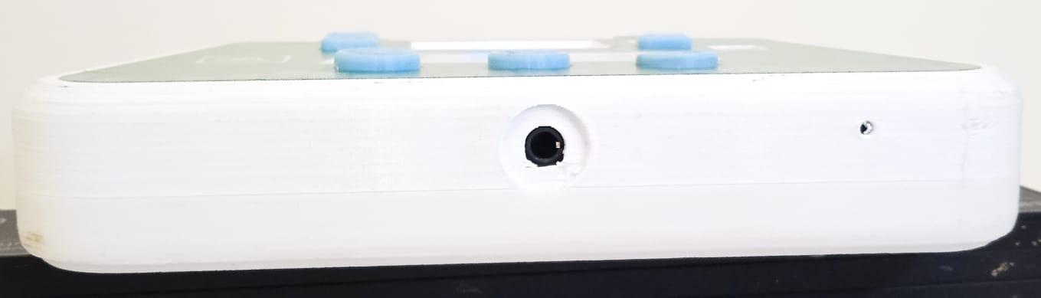
prototrial/dokumen/blue-print/manual-book/images/bawah.jpeg
