VibrasticLab/pikoakustik2/prototrial/dokumen/blue-print/manual-book/images/belakang.jpeg

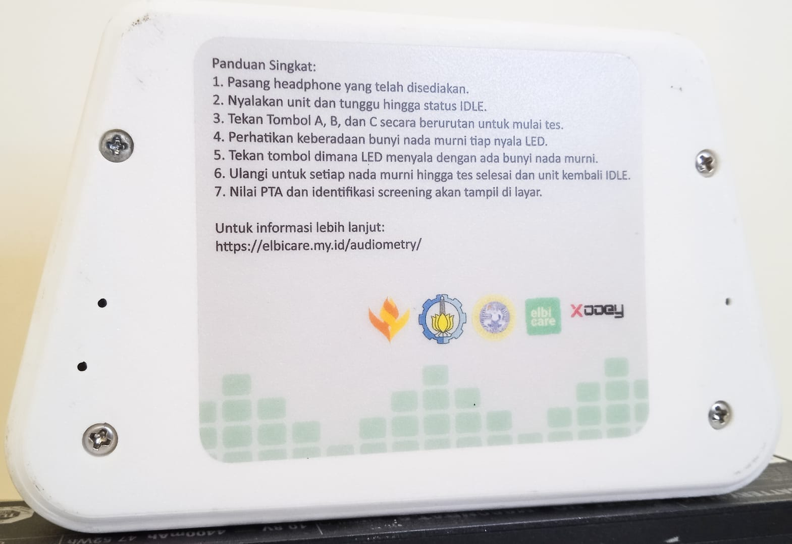
prototrial/dokumen/blue-print/manual-book/images/belakang.jpeg
