VibrasticLab/pikoakustik2/prototrial/dokumen/blue-print/manual-book/images/depan-idle.jpeg

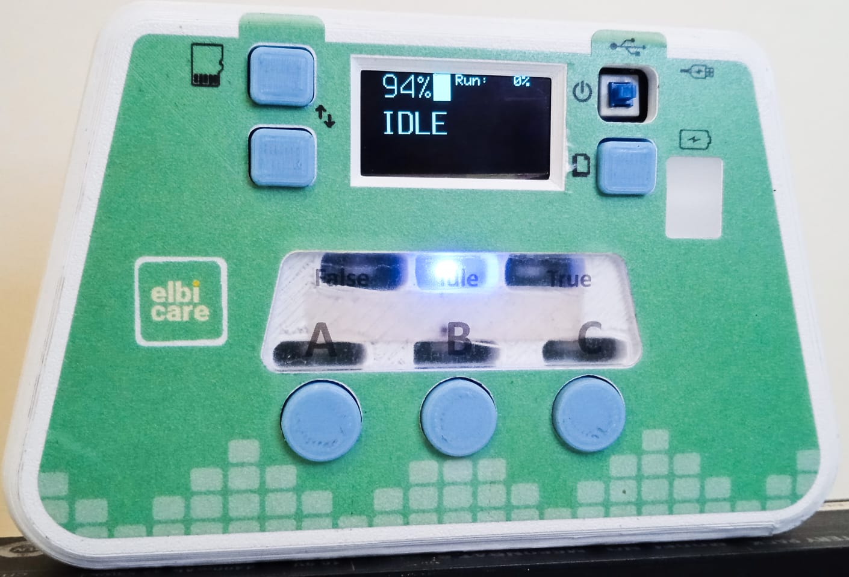
prototrial/dokumen/blue-print/manual-book/images/depan-idle.jpeg
