VibrasticLab/pikoakustik2/prototrial/dokumen/blue-print/manual-book/images/depan-PTA.jpeg

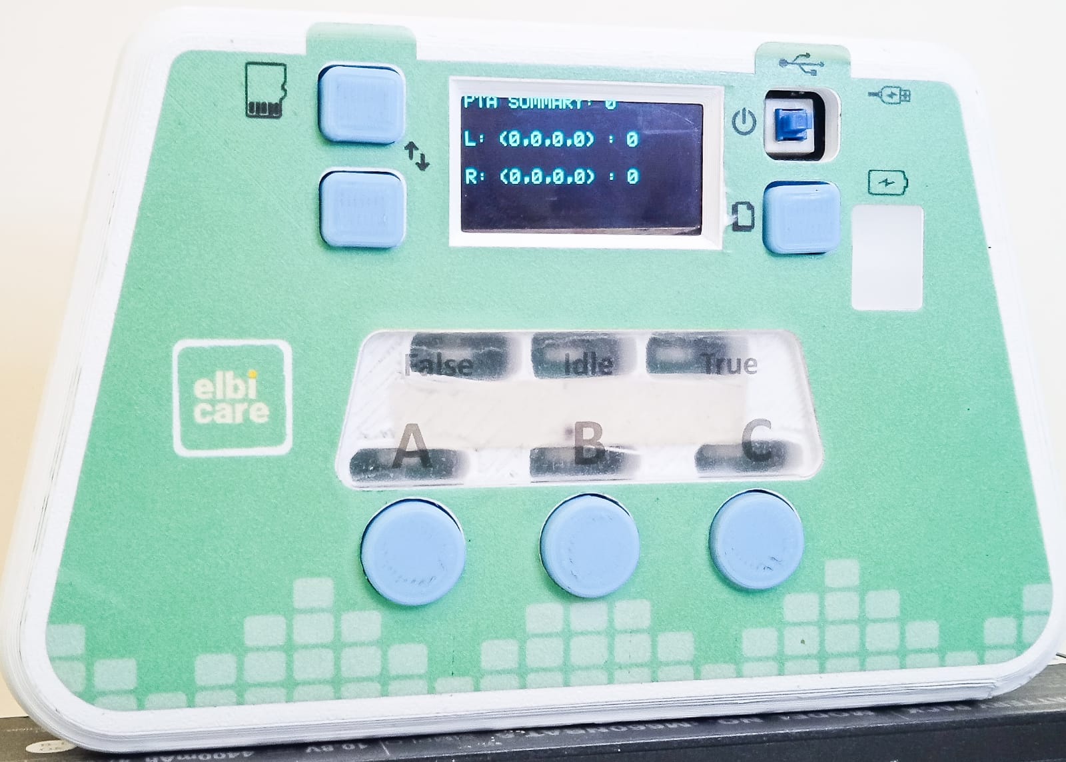
prototrial/dokumen/blue-print/manual-book/images/depan-PTA.jpeg
