VibrasticLab/pikoakustik2/prototrial/dokumen/berita_acara/itb_july2023/test_self/images/kemar_calib_slm.jpg

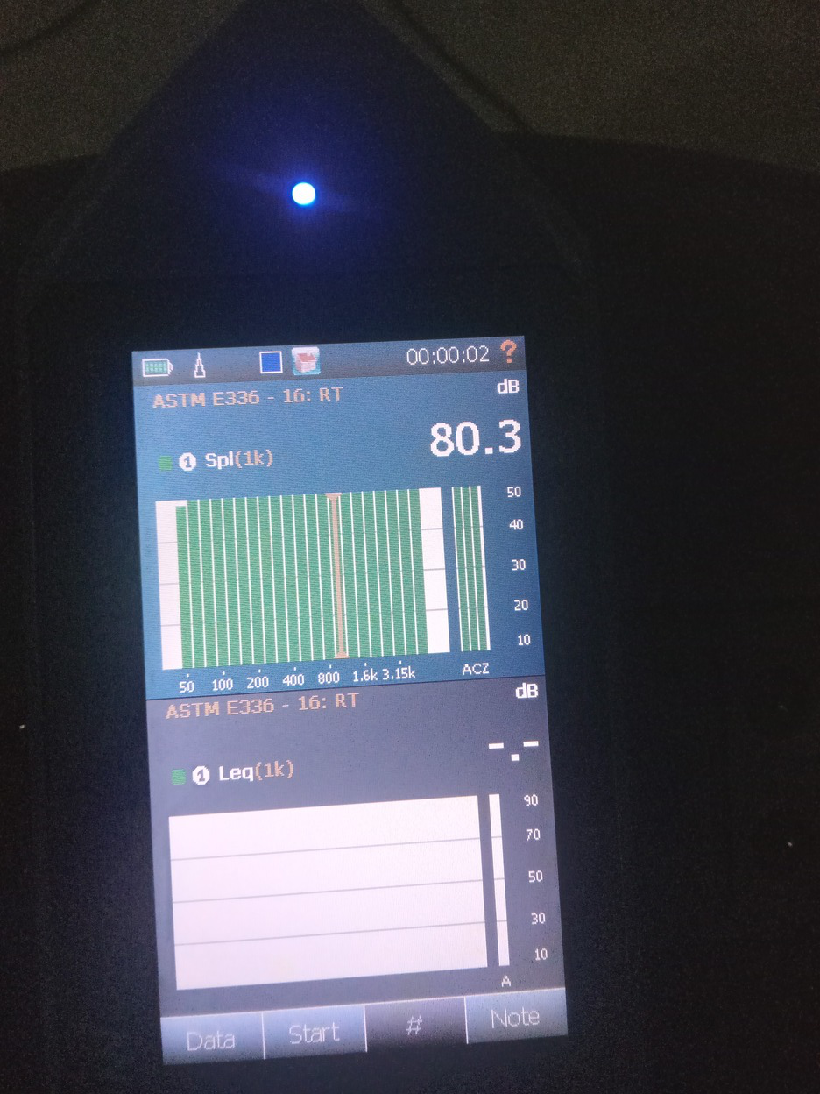
prototrial/dokumen/berita_acara/itb_july2023/test_self/images/kemar_calib_slm.jpg
