VibrasticLab/pikoakustik2/prototrial/dokumen/berita_acara/itb_july2023/test_self/images/rta.jpeg

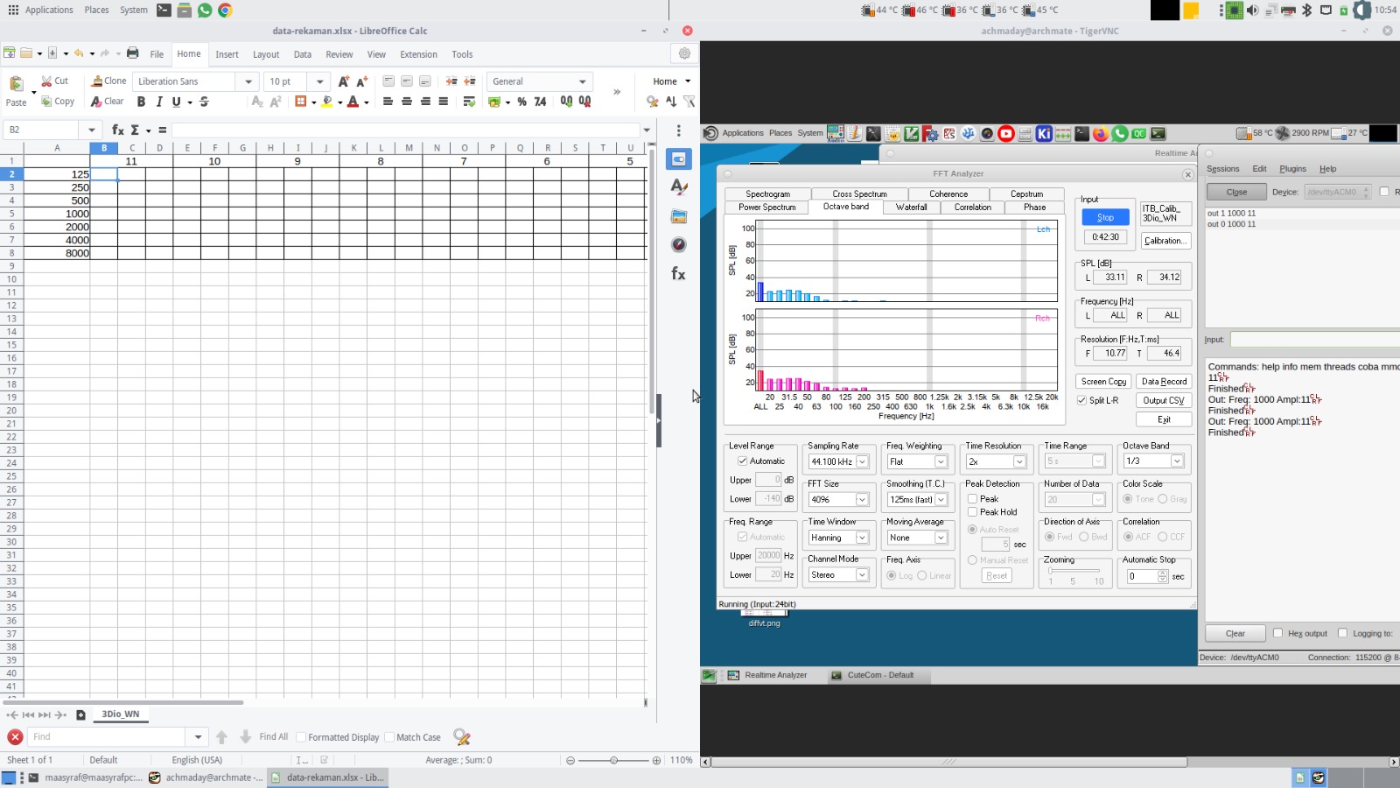
prototrial/dokumen/berita_acara/itb_july2023/test_self/images/rta.jpeg
