VibrasticLab/pikoakustik2/prototrial/dokumen/berita_acara/itb_july2023/test_self/images/software/contoh.png

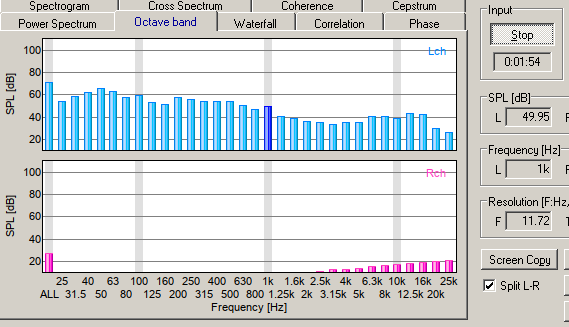
prototrial/dokumen/berita_acara/itb_july2023/test_self/images/software/contoh.png
