VibrasticLab/pikoakustik2/prototrial/circuit/altium/pikobasic_new_edited/pikobasic_new.pdf

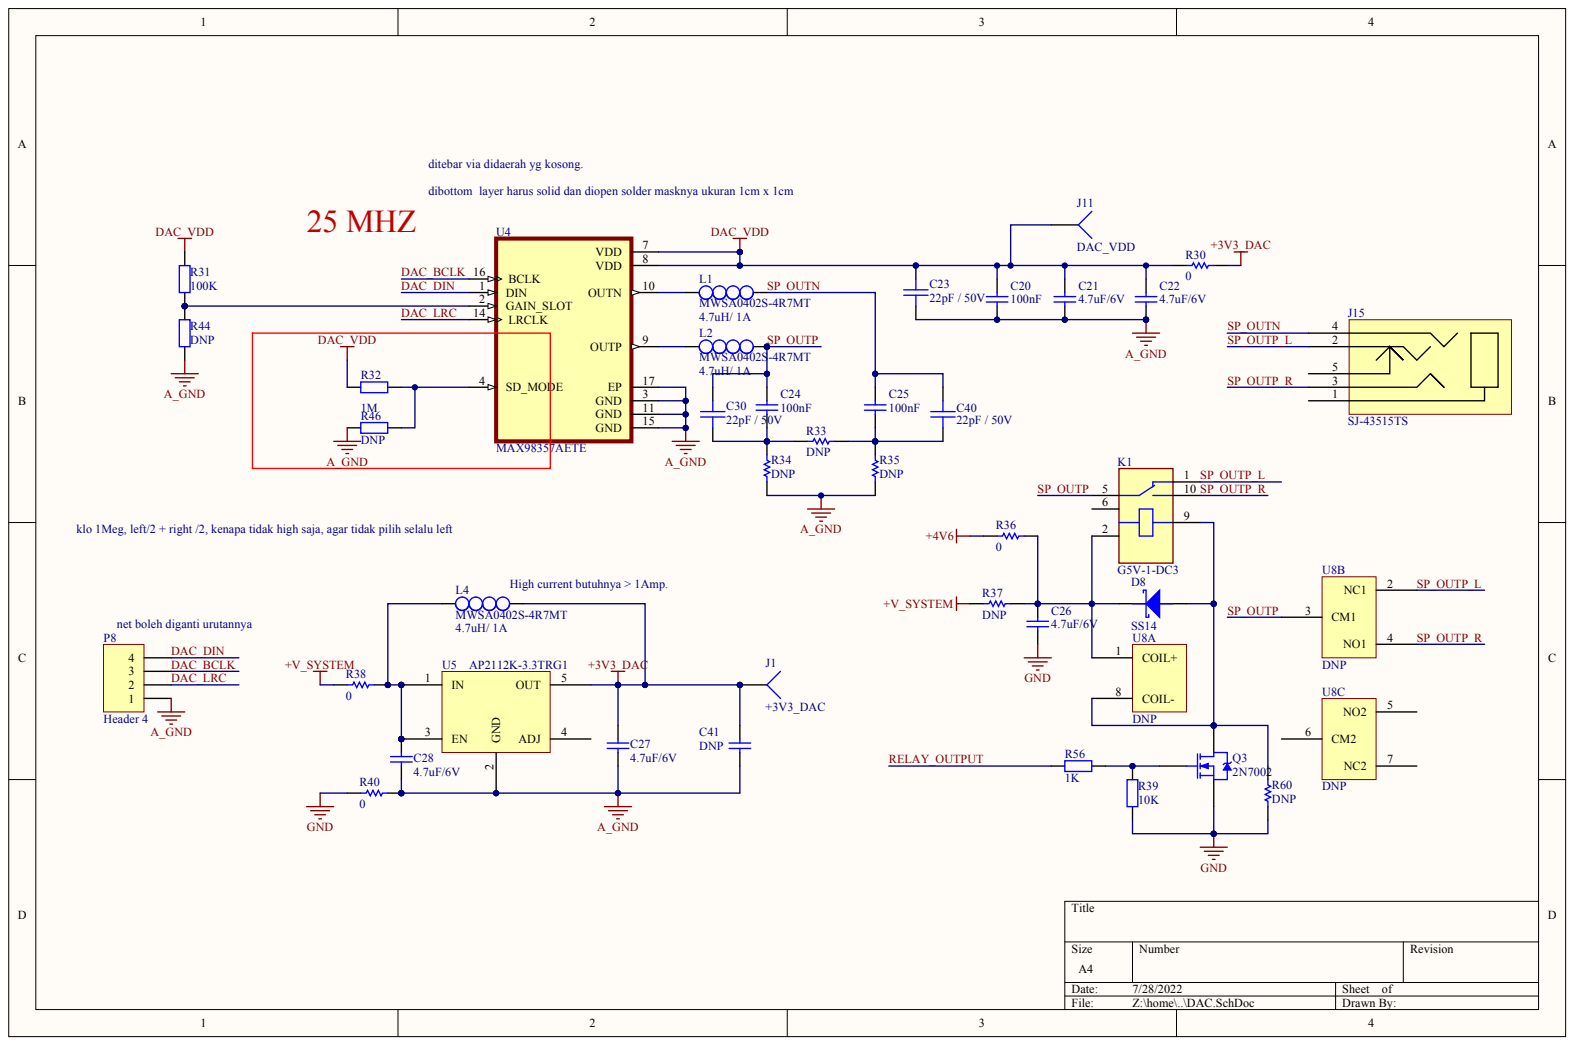
[picture p234: page 1]

ditebar via didaerah yg kosong.

dibottom layer harus solid dan diopen solder masknya ukuran 1cm x 1cm

klo 1Meg, left/2 + right /2, kenapa tidak high saja, agar tidak pilih selalu left

Size A4 | Number | Revision

Date: 7/28/2022 | Sheet of
File: Z:\home\..\DAC.SchDoc | Drawn By:

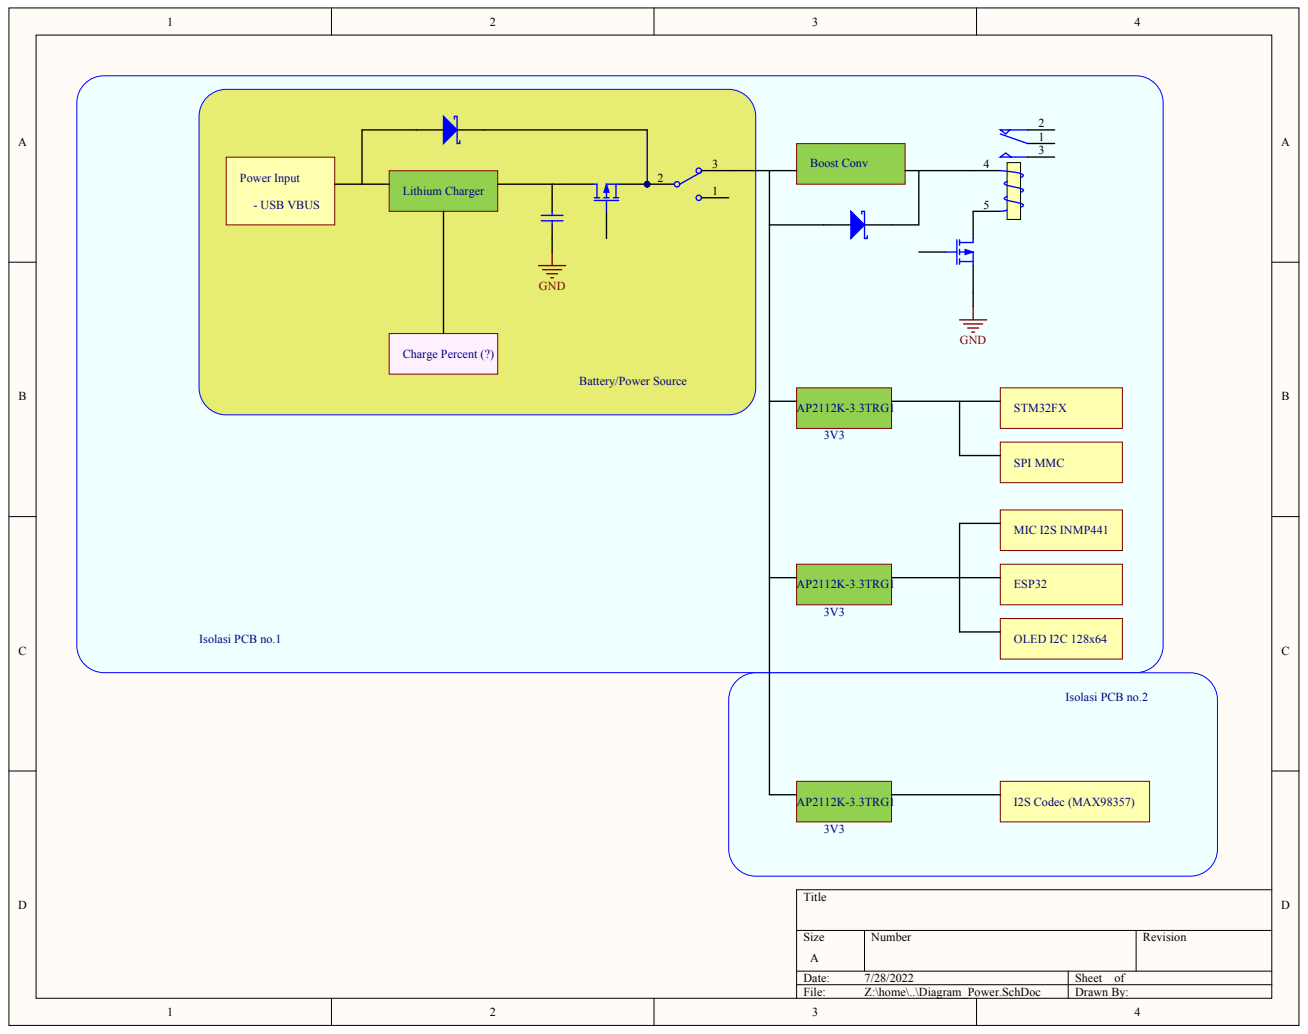
[picture p235: page 2]

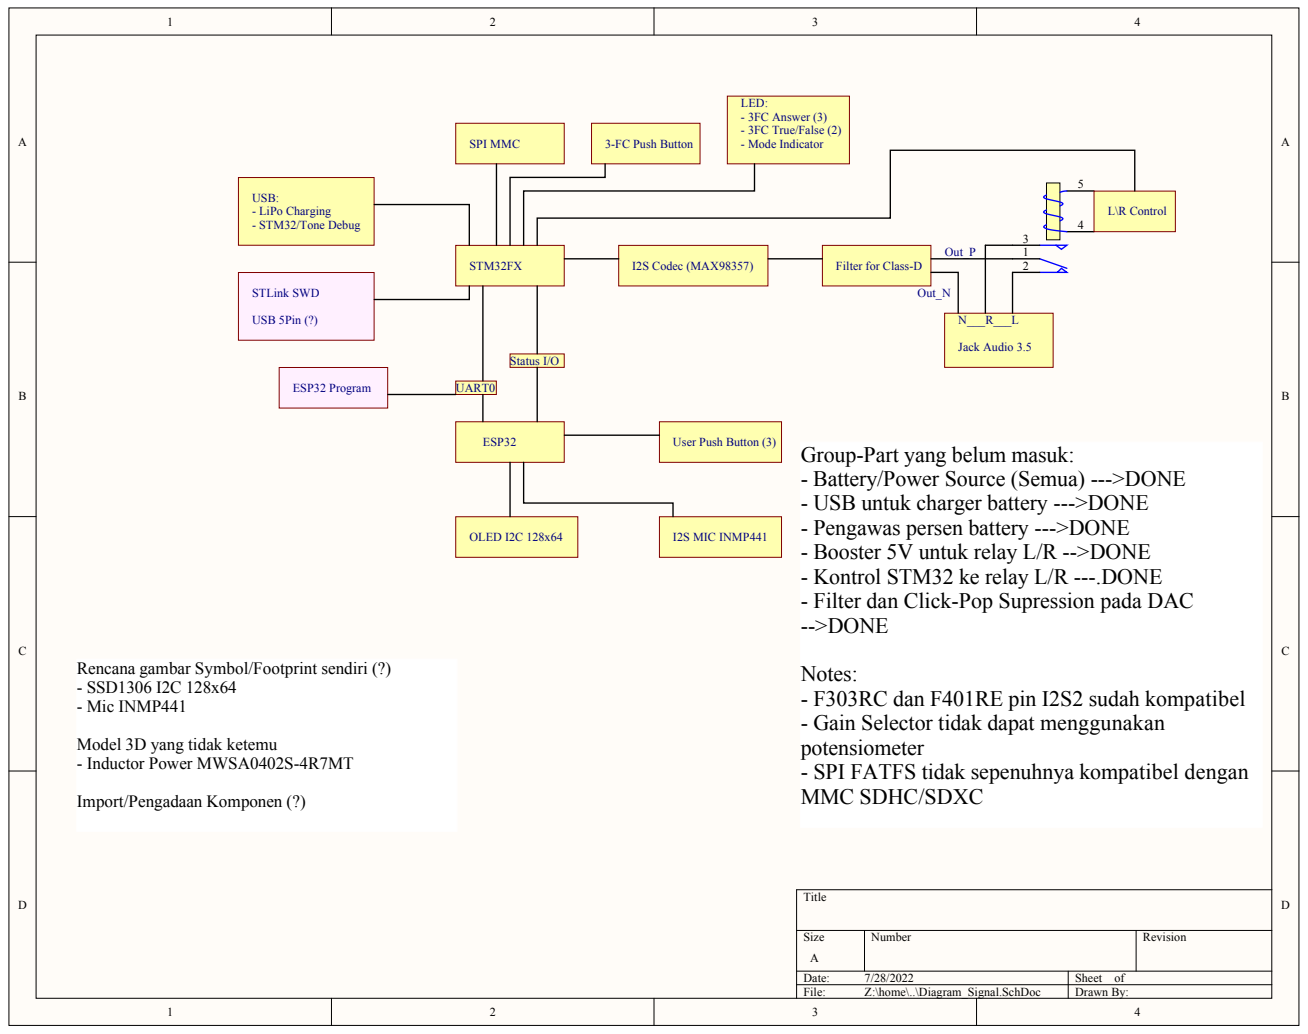
[picture p236: page 3]

Group-Part yang belum masuk:
- Battery/Power Source (Semua) --->DONE
- USB untuk charger battery --->DONE
- Pengawas persen battery --->DONE
- Booster 5V untuk relay L/R -->DONE
- Kontrol STM32 ke relay L/R ---.DONE
- Filter dan Click-Pop Supression pada DAC
-->DONE

Rencana gambar Symbol/Footprint sendiri (?)
- SSD1306 I2C 128x64
- Mic INMP441

Notes:
- F303RC dan F401RE pin I2S2 sudah kompatibel
- Gain Selector tidak dapat menggunakan
potensiometer
- SPI FATFS tidak sepenuhnya kompatibel dengan
MMC SDHC/SDXC

Model 3D yang tidak ketemu
- Inductor Power MWSA0402S-4R7MT

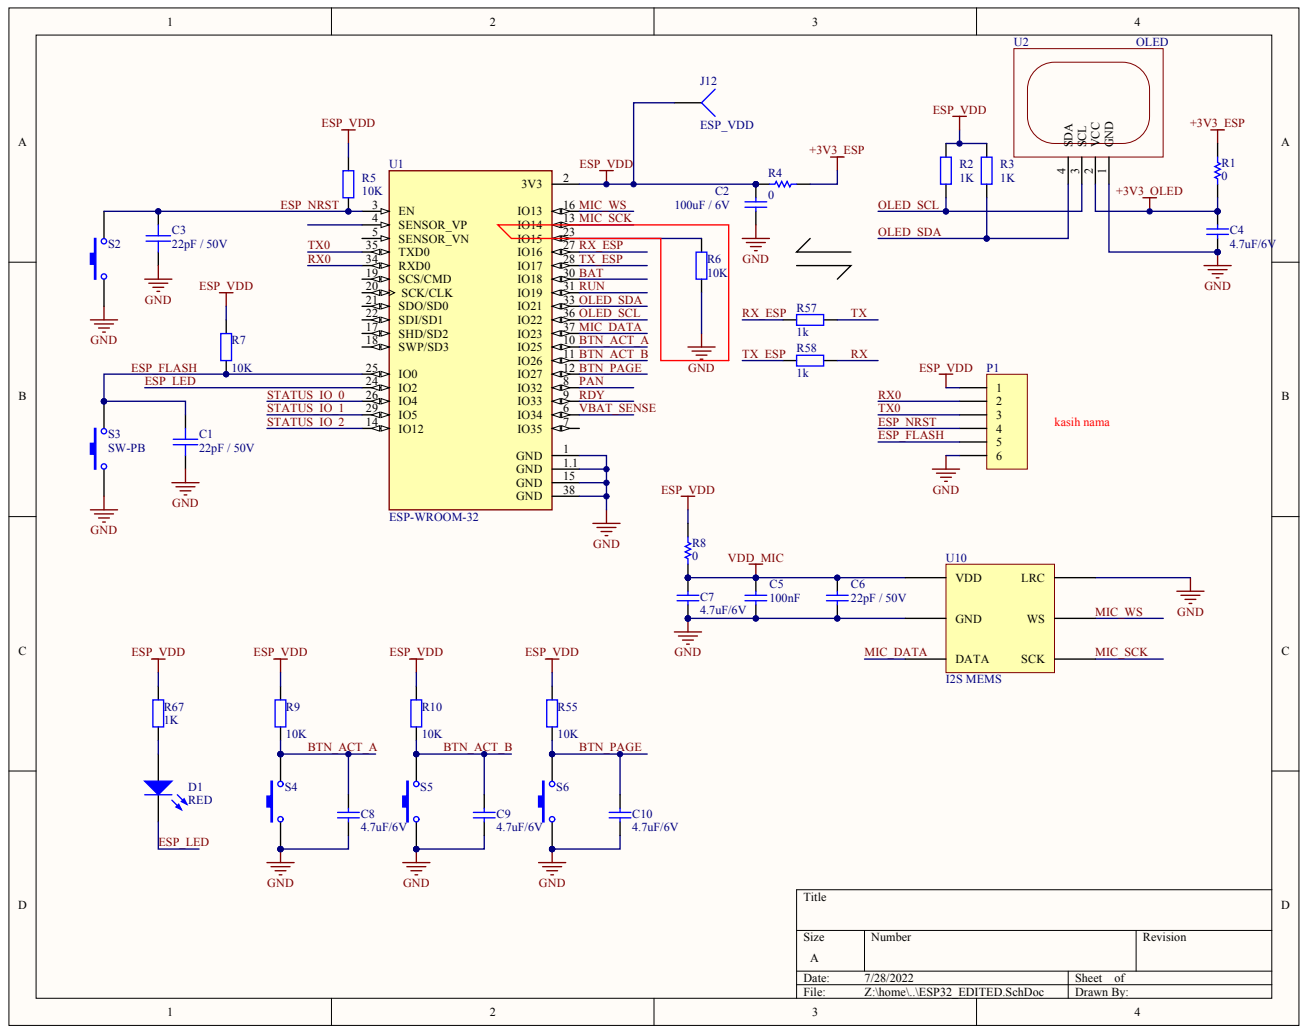
[picture p237: page 4]

+3V3_OLED

OLED_SCL

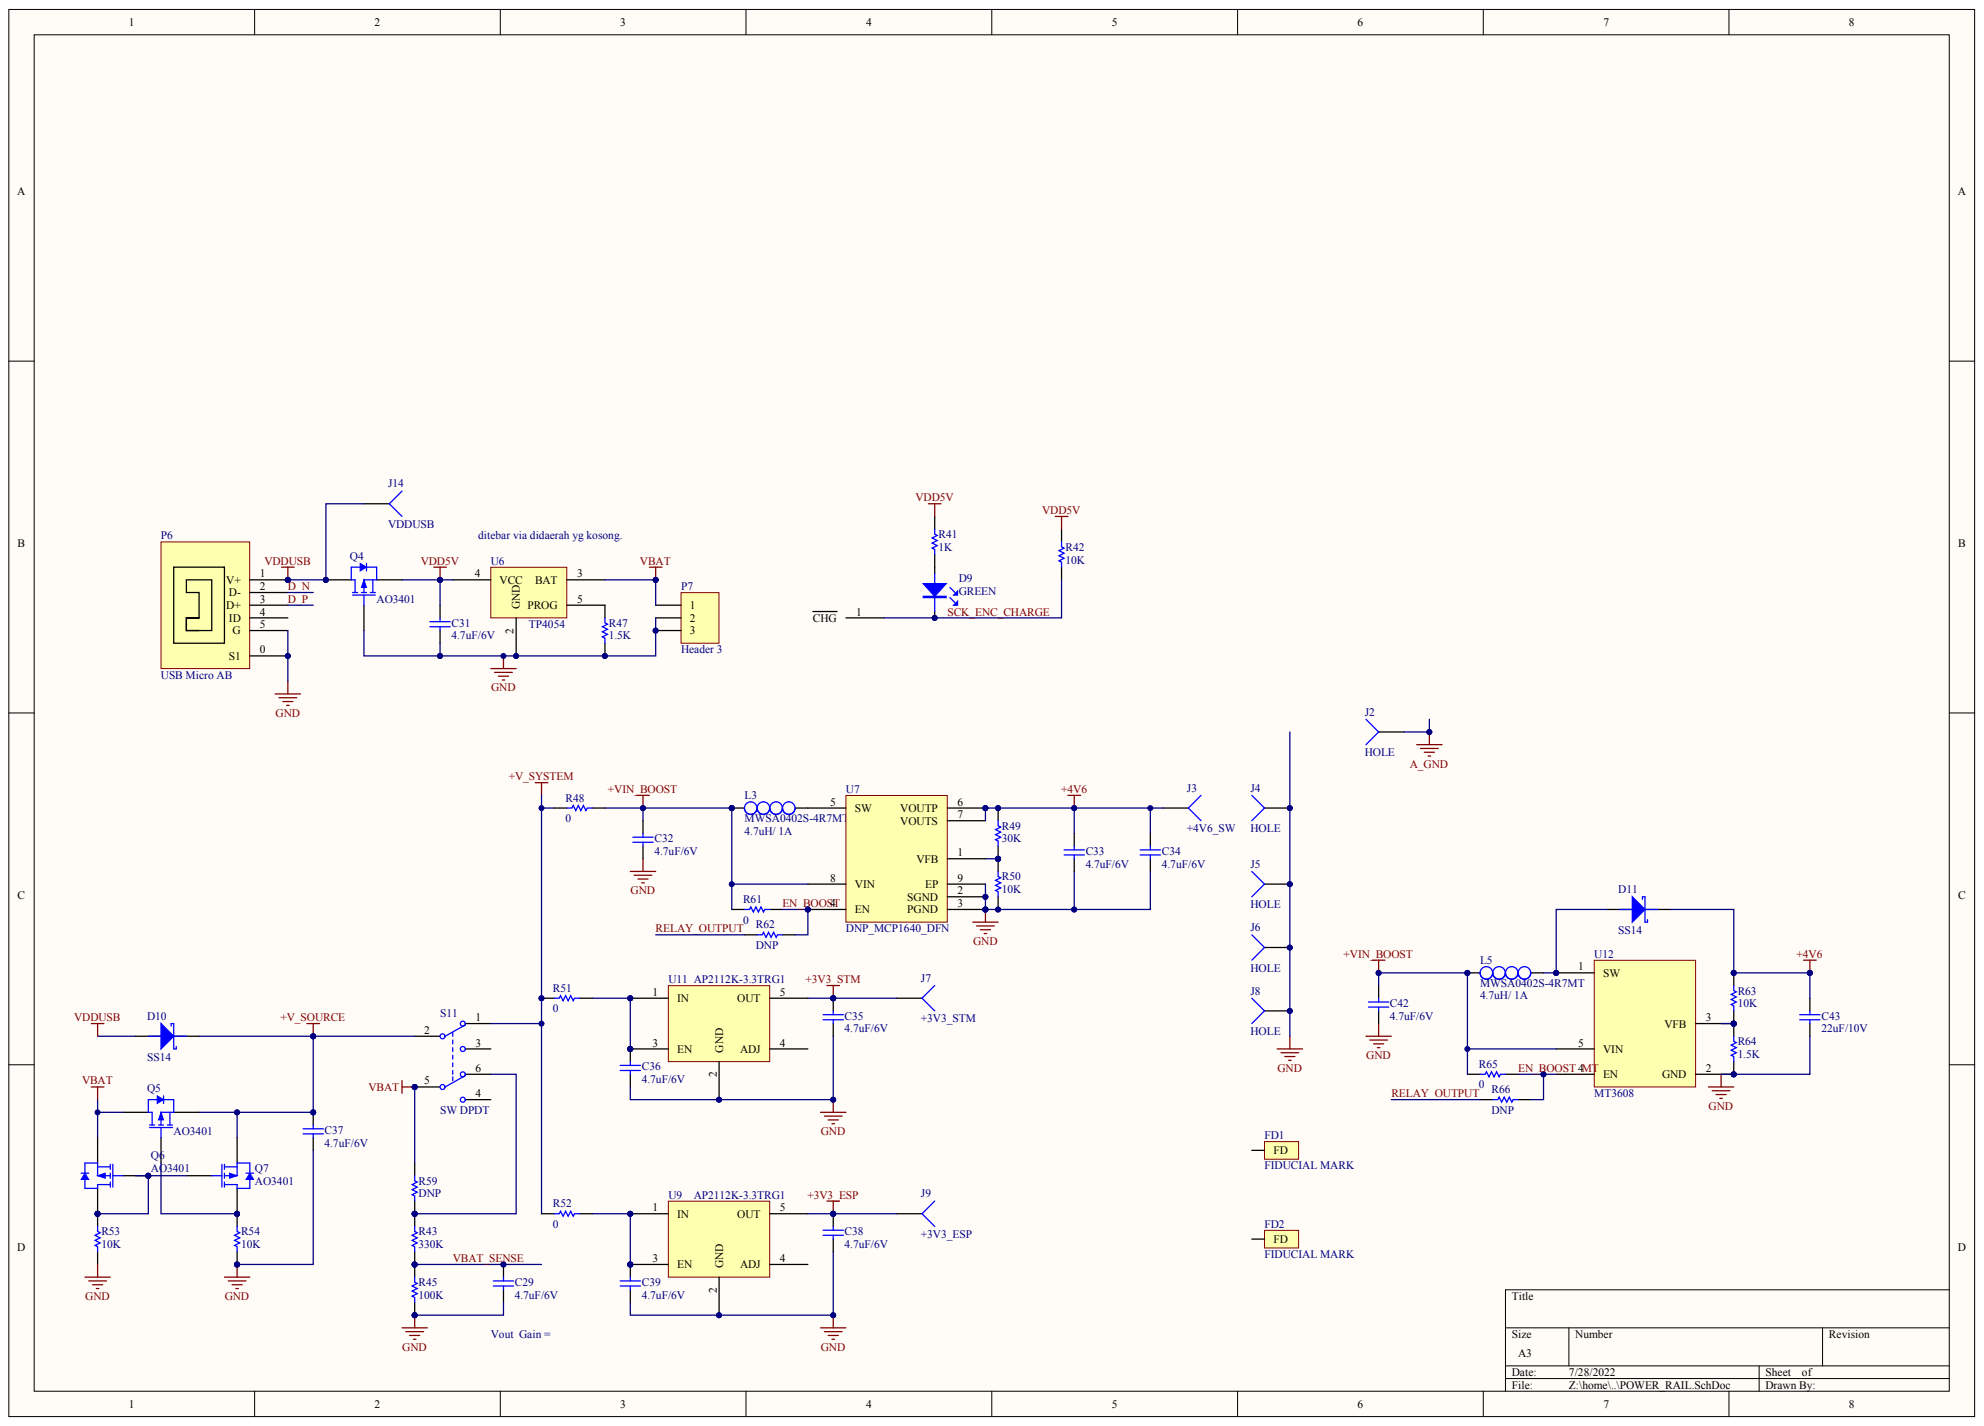
[picture p238: page 5]

ditebar via didaerah yg kosong.

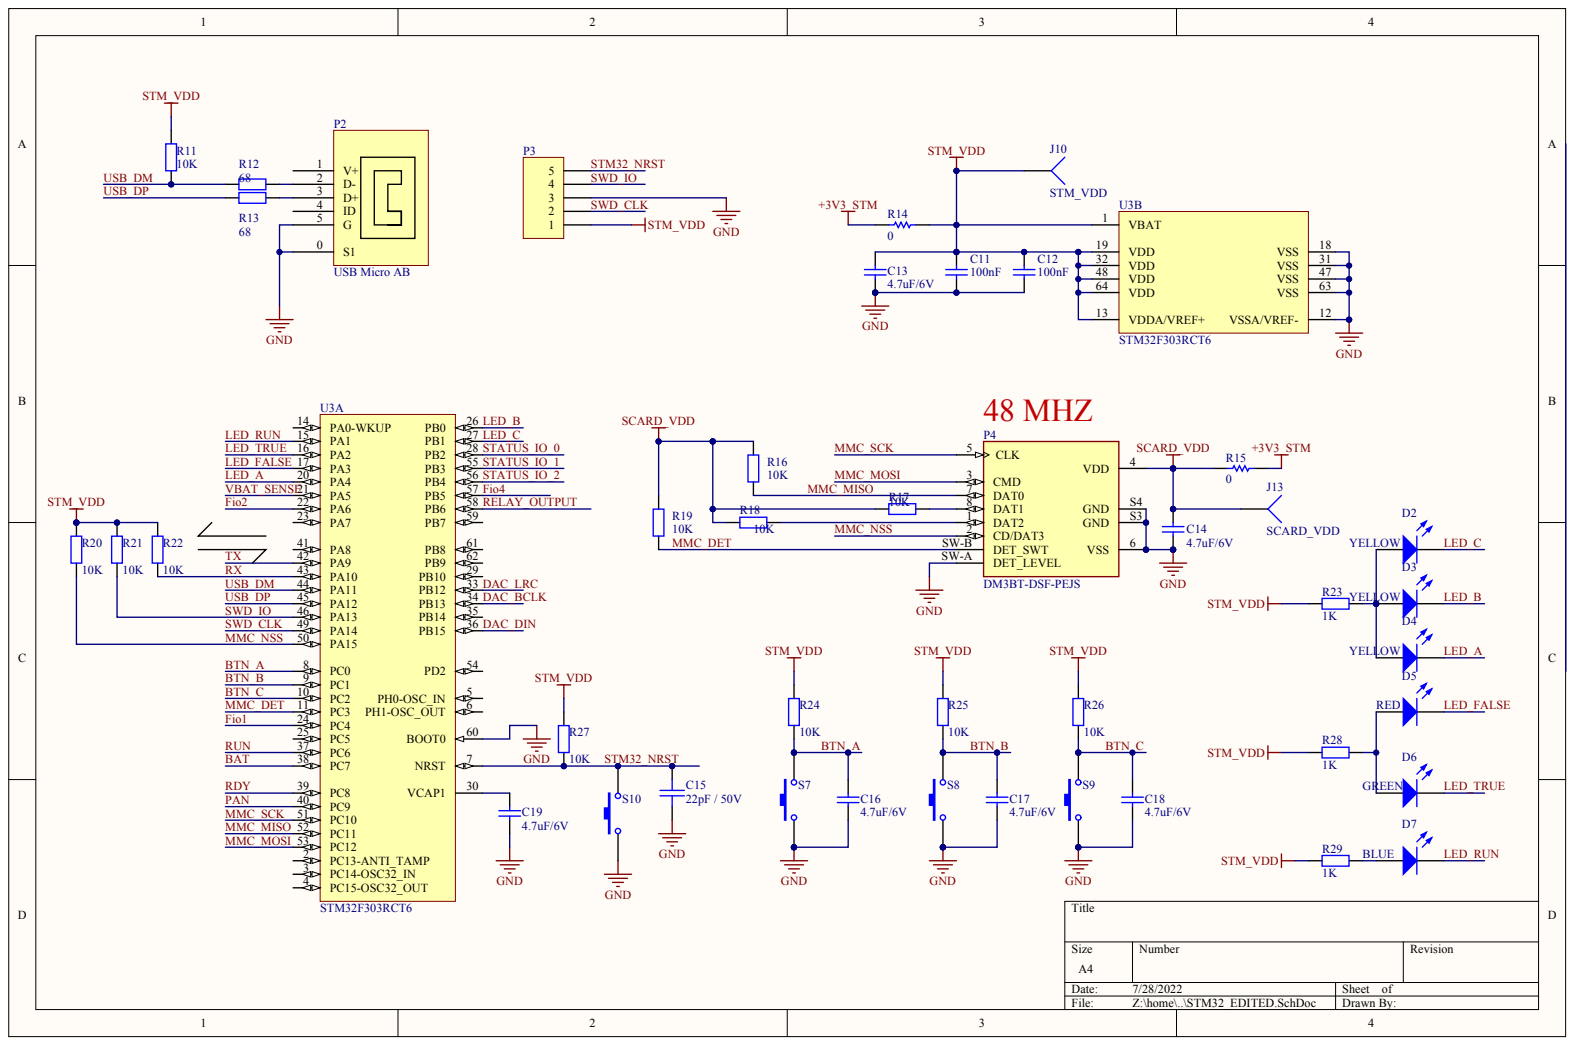
[picture p239: page 6]

Size A4 | Number | Revision

Date: 7/28/2022 | Sheet of
File: Z:\home\..\STM32_EDITED.SchDoc | Drawn By:
