VibrasticLab/pikoakustik2/(list of files, drawings)

Other design files:
prototrial/circuit/altium/pikobasic/esp32.SchDoc
prototrial/circuit/altium/pikobasic/pikobasic.PrjPcb
prototrial/circuit/altium/pikobasic/stm32.SchDoc
prototrial/circuit/altium/pikobasic_new/Diagram_Power.SchDoc
prototrial/circuit/altium/pikobasic_new/Diagram_Signal.SchDoc
prototrial/circuit/altium/pikobasic_new/esp32.SchDoc
prototrial/circuit/altium/pikobasic_new/overall.SchDoc
prototrial/circuit/altium/pikobasic_new/pikobasic_new.PrjPcb
prototrial/circuit/altium/pikobasic_new/stm32.SchDoc
prototrial/circuit/altium/pikobasic_new_edited/DAC.SchDoc
prototrial/circuit/altium/pikobasic_new_edited/Diagram_Power.SchDoc
prototrial/circuit/altium/pikobasic_new_edited/Diagram_Signal.SchDoc
prototrial/circuit/altium/pikobasic_new_edited/esp32.SchDoc
prototrial/circuit/altium/pikobasic_new_edited/ESP32_EDITED.SchDoc
prototrial/circuit/altium/pikobasic_new_edited/pikobasic_new.PrjPcb
prototrial/circuit/altium/pikobasic_new_edited/POWER_RAIL.SchDoc
prototrial/circuit/altium/pikobasic_new_edited/stm32.SchDoc
prototrial/circuit/altium/pikobasic_new_edited/STM32_EDITED.SchDoc
