VibrasticLab/pikoakustik2/actual/circuit/skema_p3/audio.kicad_sch

## KiCad design actual/circuit/skema_p3/audio.kicad_sch (2023-02-02)

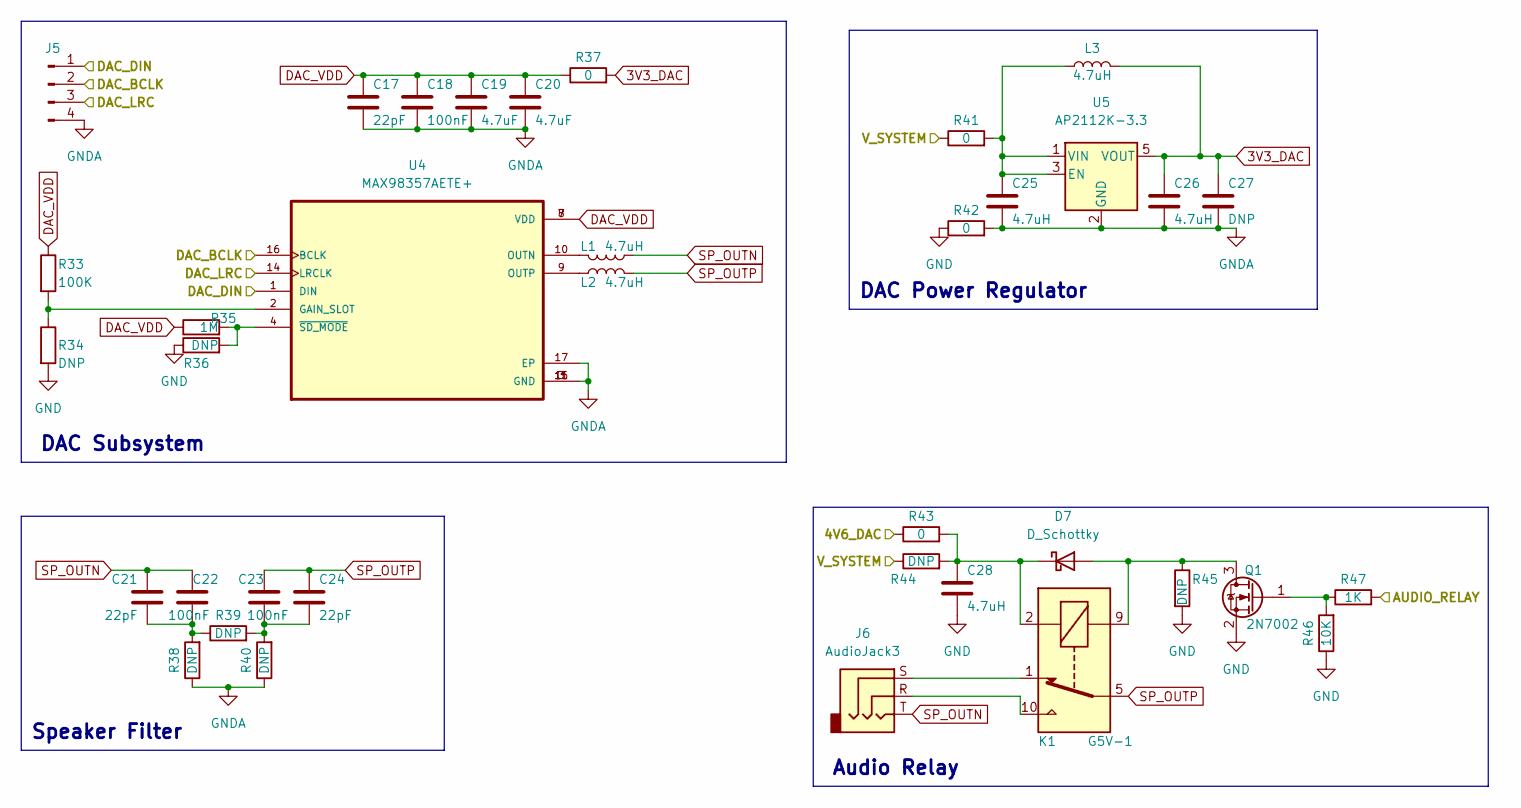
[picture p240: schematic audio.kicad_sch]

Parts:
C17, C21, C24: 22pF
C18, C22, C23: 100nF
C19, C20: 4.7uF
C25, C26, C28: 4.7uH
C27: DNP
D7: D_Schottky
J5: Conn_01x04_Male
J6: AudioJack3
K1: G5V-1; Relay_SPDT_Omron_G5V-1
L1, L2, L3: 4.7uH
Q1: 2N7002; SOT-23
R33: 100K
R34, R36, R38, R39, R40, R44, R45: DNP
R35: 1M
R37, R41, R42, R43: 0
R46: 10K
R47: 1K
U4: MAX98357AETE+; QFN50P300X300X80-17N
U5: AP2112K-3.3; SOT-23-5

Connections:
3V3_DAC: C26.1, C27.1, L3.2, R37.2, U5.5 (VOUT)
4V6_DAC: R43.1
AUDIO_RELAY: R47.2
DAC_BCLK: J5.2, U4.16 (BCLK)
DAC_DIN: J5.1, U4.1 (DIN)
DAC_LRC: J5.3, U4.14 (LRCLK)
DAC_VDD: C17.1, C18.1, C19.1, C20.1, R33.1, R35.1, R37.1, U4.7 (VDD), U4.8 (VDD)
GND: C28.2, Q1.2 (S), R34.2, R36.1, R42.1, R45.2, R46.1
GNDA: C17.2, C18.2, C19.2, C20.2, C25.2, C26.2, C27.2, J5.4, R38.1, R40.1, R42.2, U4.3 (GND), U4.11 (GND), U4.15 (GND), U4.17 (EP), U5.2 (GND)
unnamed: C21.2, C22.2, R38.2, R39.1
unnamed: C23.2, C24.2, R39.2, R40.2
unnamed: C25.1, L3.1, R41.2, U5.1 (VIN), U5.3 (EN)
unnamed: C28.1, D7.1 (K), K1.2, R43.2, R44.2
unnamed: D7.2 (A), K1.9, Q1.3 (D), R45.1
unnamed: J6.R, K1.10
unnamed: J6.S, K1.1
unnamed: L1.2, U4.10 (OUTN)
unnamed: L2.2, U4.9 (OUTP)
unnamed: Q1.1 (G), R46.2, R47.1
unnamed: R33.2, R34.1, U4.2 (GAIN_SLOT)
unnamed: R35.2, R36.2, U4.4 (~SD_MODE)
SP_OUTN: C21.1, C22.1, J6.T, L1.1
SP_OUTP: C23.1, C24.1, K1.5, K1.6, L2.1
V_SYSTEM: R41.1, R44.1

Notes on the sheet:
DAC Power Regulator
Speaker Filter
DAC Subsystem
Audio Relay
