VibrasticLab/pikoakustik2/actual/circuit/skema_p3/esp32.kicad_sch

## KiCad design actual/circuit/skema_p3/esp32.kicad_sch (2023-02-02)

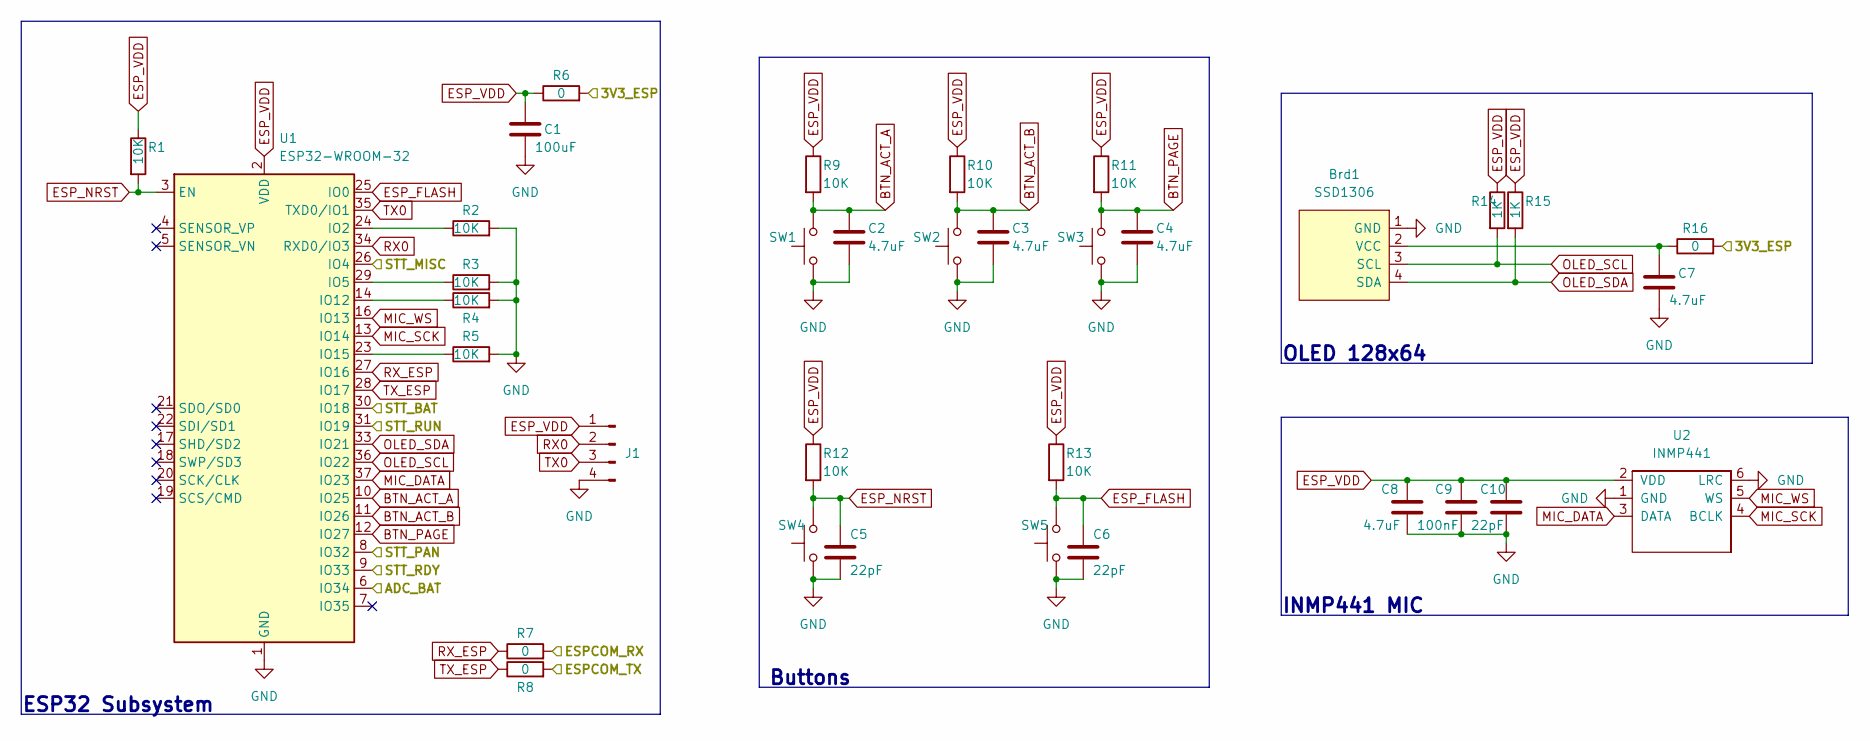
[picture p241: schematic esp32.kicad_sch]

Parts:
Brd1: SSD1306
C1: 100uF
C2, C3, C4, C7, C8: 4.7uF
C5, C6, C10: 22pF
C9: 100nF
J1: Conn_01x04_Male
R1, R2, R3, R4, R5, R9, R10, R11, R12, R13: 10K
R6, R7, R8, R16: 0
R14, R15: 1K
SW1, SW2, SW3, SW4, SW5: SW_Push
U1: ESP32-WROOM-32
U2: INMP441

Connections:
3V3_ESP: R6.2, R16.2
ADC_BAT: U1.6 (IO34)
BTN_ACT_A: C2.1, R9.2, SW1.2, U1.10 (IO25)
BTN_ACT_B: C3.1, R10.2, SW2.2, U1.11 (IO26)
BTN_PAGE: C4.1, R11.2, SW3.2, U1.12 (IO27)
ESPCOM_RX: R7.2
ESPCOM_TX: R8.2
ESP_FLASH: C6.1, R13.2, SW5.2, U1.25 (IO0)
ESP_NRST: C5.1, R1.2, R12.2, SW4.2, U1.3 (EN)
ESP_VDD: C1.1, C8.1, C9.1, C10.1, J1.1, R1.1, R6.1, R9.1, R10.1, R11.1, R12.1, R13.1, R14.1, R15.1, U1.2 (VDD), U2.2 (VDD)
GND: Brd1.1 (GND), C1.2, C2.2, C3.2, C4.2, C5.2, C6.2, C7.2, C8.2, C9.2, C10.2, J1.4, R2.2, R3.2, R4.2, R5.2, SW1.1, SW2.1, SW3.1, SW4.1, SW5.1, U1.1 (GND), U1.15 (GND), U1.38 (GND), U1.39 (GND), U2.1 (GND), U2.6 (LRC)
MIC_DATA: U1.37 (IO23), U2.3 (DATA)
MIC_SCK: U1.13 (IO14), U2.4 (BCLK)
MIC_WS: U1.16 (IO13), U2.5 (WS)
unnamed: Brd1.2 (VCC), C7.1, R16.1
unnamed: R2.1, U1.24 (IO2)
unnamed: R3.1, U1.29 (IO5)
unnamed: R4.1, U1.14 (IO12)
unnamed: R5.1, U1.23 (IO15)
OLED_SCL: Brd1.3 (SCL), R14.2, U1.36 (IO22)
OLED_SDA: Brd1.4 (SDA), R15.2, U1.33 (IO21)
RX0: J1.2, U1.34 (RXD0/IO3)
RX_ESP: R7.1, U1.27 (IO16)
STT_BAT: U1.30 (IO18)
STT_MISC: U1.26 (IO4)
STT_PAN: U1.8 (IO32)
STT_RDY: U1.9 (IO33)
STT_RUN: U1.31 (IO19)
TX0: J1.3, U1.35 (TXD0/IO1)
TX_ESP: R8.1, U1.28 (IO17)

Notes on the sheet:
Buttons
ESP32 Subsystem
INMP441 MIC
OLED 128x64
