VibrasticLab/pikoakustik2/actual/circuit/skema_p3/power.kicad_sch

## KiCad design actual/circuit/skema_p3/power.kicad_sch (2023-02-03)

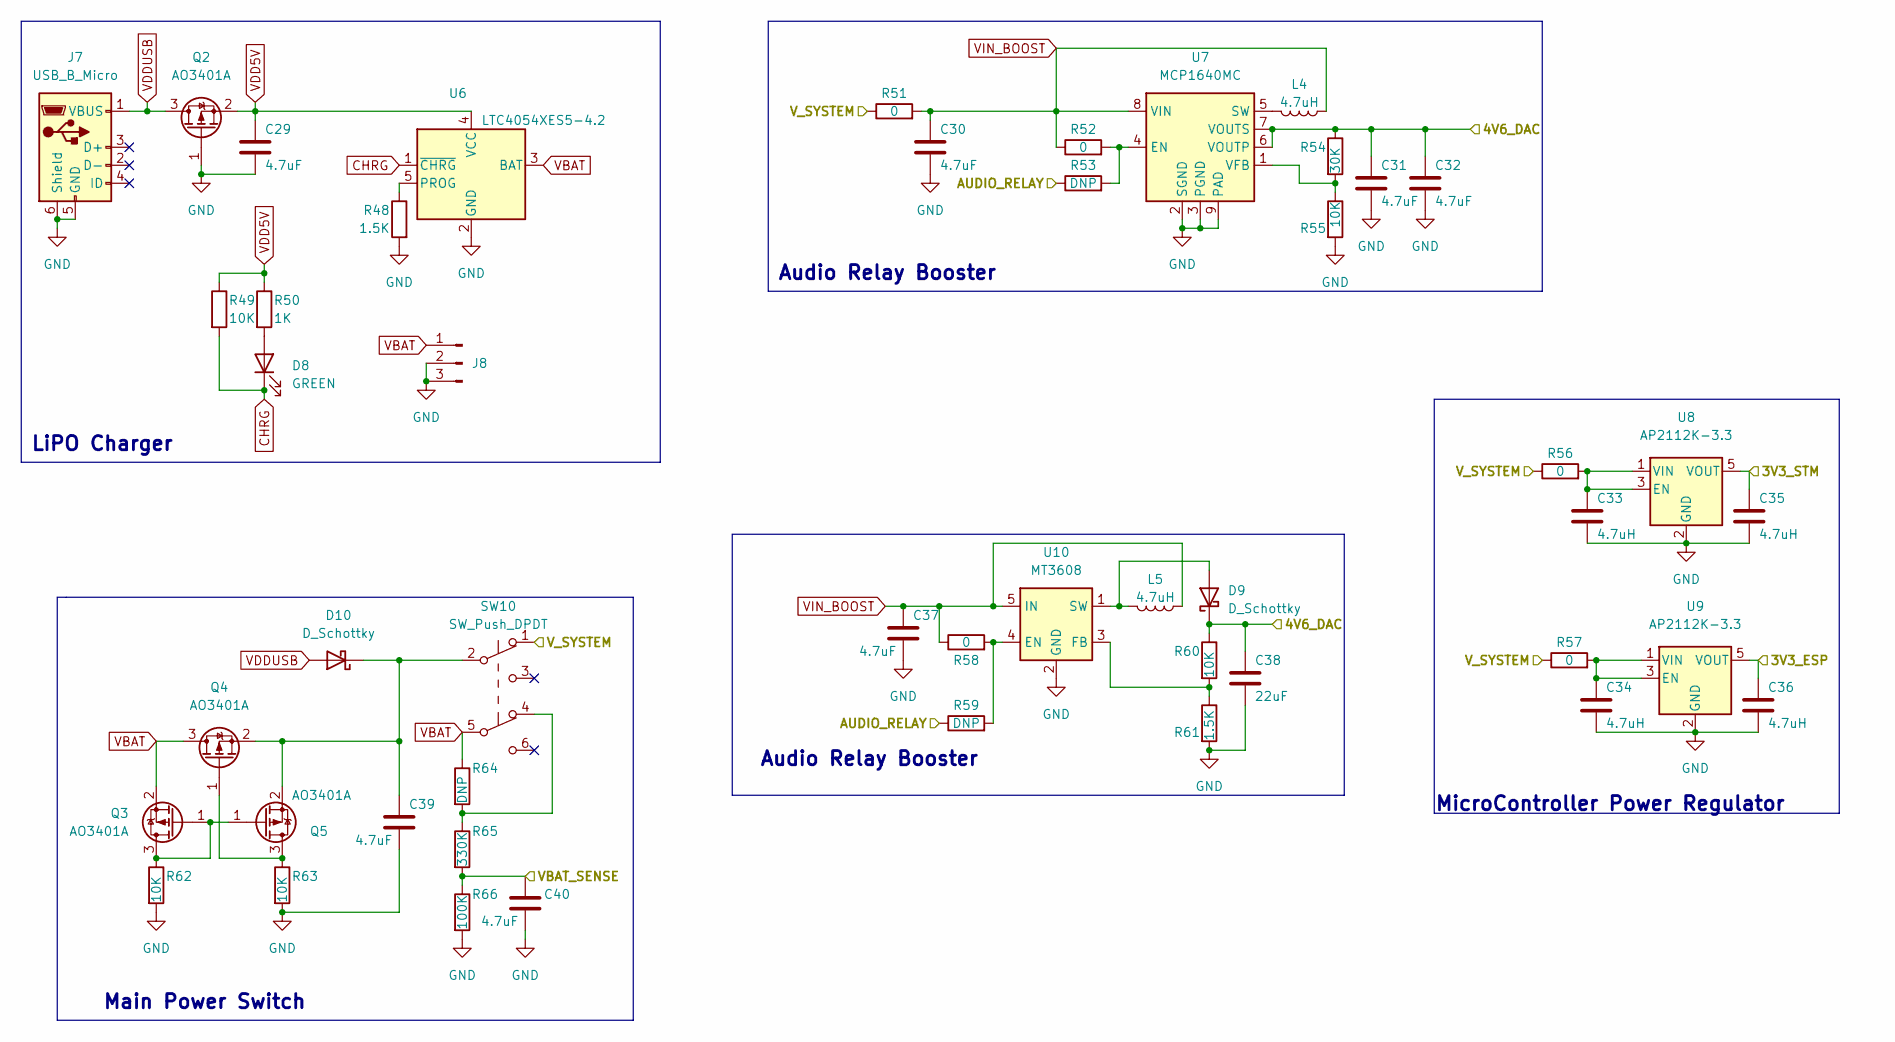
[picture p242: schematic power.kicad_sch]

Parts:
C29, C30, C31, C32, C37, C39, C40: 4.7uF
C33, C34, C35, C36: 4.7uH
C38: 22uF
D8: GREEN
D9, D10: D_Schottky
J7: USB_B_Micro
J8: Conn_01x03_Male
L4, L5: 4.7uH
Q2, Q3, Q4, Q5: AO3401A; SOT-23
R48, R61: 1.5K
R49, R55, R60, R62, R63: 10K
R50: 1K
R51, R52, R56, R57, R58: 0
R53, R59, R64: DNP
R54: 30K
R65: 330K
R66: 100K
SW10: SW_Push_DPDT
U6: LTC4054XES5-4.2; TSOT-23-5
U7: MCP1640MC; DFN-8-1EP_3x2mm_P0.5mm_EP1.75x1.45mm
U8, U9: AP2112K-3.3; SOT-23-5
U10: MT3608; SOT-23-6

Connections:
3V3_ESP: C36.1, U9.5 (VOUT)
3V3_STM: C35.1, U8.5 (VOUT)
4V6_DAC: C31.1, C32.1, C38.1, D9.1 (K), R54.1, R60.1, U7.6 (VOUTP), U7.7 (VOUTS)
AUDIO_RELAY: R53.1, R59.1
CHRG: D8.1 (K), R49.2, U6.1 (~CHRG)
GND: C29.2, C30.2, C31.2, C32.2, C33.2, C34.2, C35.2, C36.2, C37.2, C38.2, C39.2, C40.2, J7.5 (GND), J7.6 (Shield), J8.2, J8.3, Q2.1 (G), R48.2, R55.2, R61.2, R62.2, R63.2, R66.2, U6.2 (GND), U7.2 (SGND), U7.3 (PGND), U7.9 (PAD), U8.2 (GND), U9.2 (GND), U10.2 (GND)
unnamed: C33.1, R56.2, U8.1 (VIN), U8.3 (EN)
unnamed: C34.1, R57.2, U9.1 (VIN), U9.3 (EN)
unnamed: C39.1, D10.1 (K), Q4.2 (S), Q5.2 (S), SW10.2 (B)
unnamed: D8.2 (A), R50.2
unnamed: D9.2 (A), L5.2, U10.1 (SW)
unnamed: L4.2, U7.5 (SW)
unnamed: Q3.1 (G), Q3.3 (D), Q5.1 (G), R62.1
unnamed: Q4.1 (G), Q5.3 (D), R63.1
unnamed: R48.1, U6.5 (PROG)
unnamed: R52.2, R53.2, U7.4 (EN)
unnamed: R54.2, R55.1, U7.1 (VFB)
unnamed: R58.2, R59.2, U10.4 (EN)
unnamed: R60.2, R61.1, U10.3 (FB)
unnamed: R64.2, R65.1, SW10.4 (A)
VBAT: J8.1, Q3.2 (S), Q4.3 (D), R64.1, SW10.5 (B), U6.3 (BAT)
VBAT_SENSE: C40.1, R65.2, R66.1
VDD5V: C29.1, Q2.2 (S), R49.1, R50.1, U6.4 (VCC)
VDDUSB: D10.2 (A), J7.1 (VBUS), Q2.3 (D)
VIN_BOOST: C30.1, C37.1, L4.1, L5.1, R51.2, R52.1, R58.1, U7.8 (VIN), U10.5 (IN)
V_SYSTEM: R51.1, R56.1, R57.1, SW10.1 (A)

Notes on the sheet:
Main Power Switch
Audio Relay Booster
MicroController Power Regulator
LiPO Charger
