VibrasticLab/pikoakustik2/actual/circuit/skema_p3/stm32.kicad_sch

## KiCad design actual/circuit/skema_p3/stm32.kicad_sch (2023-02-03)

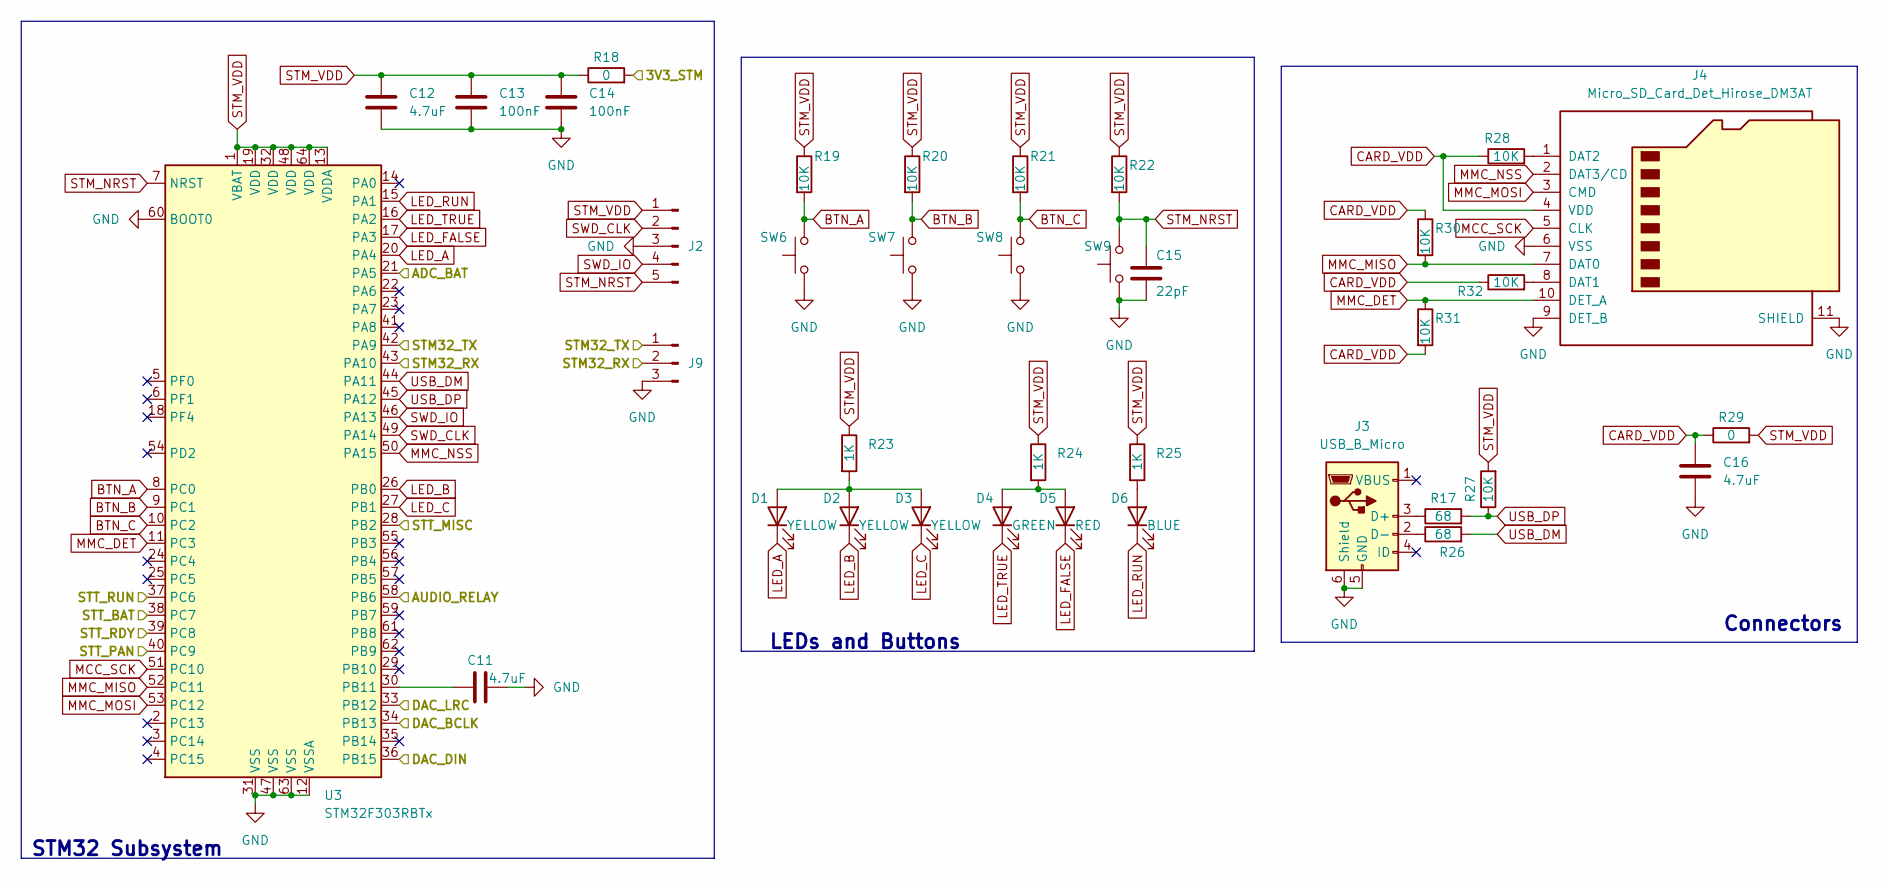
[picture p243: schematic stm32.kicad_sch]

Parts:
C11, C12, C16: 4.7uF
C13, C14: 100nF
C15: 22pF
D1, D2, D3: YELLOW
D4: GREEN
D5: RED
D6: BLUE
J2: Conn_01x05_Male
J3: USB_B_Micro
J4: Micro_SD_Card_Det_Hirose_DM3AT
J9: Conn_01x03_Male
R17, R26: 68
R18, R29: 0
R19, R20, R21, R22, R27, R28, R30, R31, R32: 10K
R23, R24, R25: 1K
SW6, SW7, SW8, SW9: SW_Push
U3: STM32F303RBTx; LQFP-64_10x10mm_P0.5mm

Connections:
3V3_STM: R18.2
ADC_BAT: U3.21 (PA5)
AUDIO_RELAY: U3.58 (PB6)
BTN_A: R19.2, SW6.2, U3.8 (PC0)
BTN_B: R20.2, SW7.2, U3.9 (PC1)
BTN_C: R21.2, SW8.2, U3.10 (PC2)
CARD_VDD: C16.1, J4.4 (VDD), R28.1, R29.1, R30.1, R31.2, R32.1
DAC_BCLK: U3.34 (PB13)
DAC_DIN: U3.36 (PB15)
DAC_LRC: U3.33 (PB12)
GND: C11.2, C12.2, C13.2, C14.2, C15.2, C16.2, J2.3, J3.5 (GND), J3.6 (Shield), J4.6 (VSS), J4.9 (DET_B), J4.11 (SHIELD), J9.3, SW6.1, SW7.1, SW8.1, SW9.1, U3.12 (VSSA), U3.31 (VSS), U3.47 (VSS), U3.60 (BOOT0), U3.63 (VSS)
LED_A: D1.1 (K), U3.20 (PA4)
LED_B: D2.1 (K), U3.26 (PB0)
LED_C: D3.1 (K), U3.27 (PB1)
LED_FALSE: D5.1 (K), U3.17 (PA3)
LED_RUN: D6.1 (K), U3.15 (PA1)
LED_TRUE: D4.1 (K), U3.16 (PA2)
MCC_SCK: J4.5 (CLK), U3.51 (PC10)
MMC_DET: J4.10 (DET_A), R31.1, U3.11 (PC3)
MMC_MISO: J4.7 (DAT0), R30.2, U3.52 (PC11)
MMC_MOSI: J4.3 (CMD), U3.53 (PC12)
MMC_NSS: J4.2 (DAT3/CD), U3.50 (PA15)
unnamed: C11.1, U3.30 (PB11)
unnamed: D1.2 (A), D2.2 (A), D3.2 (A), R23.2
unnamed: D4.2 (A), D5.2 (A), R24.2
unnamed: D6.2 (A), R25.2
unnamed: J3.2 (D-), R26.1
unnamed: J3.3 (D+), R17.1
unnamed: J4.1 (DAT2), R28.2
unnamed: J4.8 (DAT1), R32.2
STM32_RX: J9.2, U3.43 (PA10)
STM32_TX: J9.1, U3.42 (PA9)
STM_NRST: C15.1, J2.5, R22.2, SW9.2, U3.7 (NRST)
STM_VDD: C12.1, C13.1, C14.1, J2.1, R18.1, R19.1, R20.1, R21.1, R22.1, R23.1, R24.1, R25.1, R27.2, R29.2, U3.1 (VBAT), U3.13 (VDDA), U3.19 (VDD), U3.32 (VDD), U3.48 (VDD), U3.64 (VDD)
STT_BAT: U3.38 (PC7)
STT_MISC: U3.28 (PB2)
STT_PAN: U3.40 (PC9)
STT_RDY: U3.39 (PC8)
STT_RUN: U3.37 (PC6)
SWD_CLK: J2.2, U3.49 (PA14)
SWD_IO: J2.4, U3.46 (PA13)
USB_DM: R26.2, U3.44 (PA11)
USB_DP: R17.2, R27.1, U3.45 (PA12)

Notes on the sheet:
LEDs and Buttons
STM32 Subsystem
Connectors
