VibrasticLab/pikoakustik2/prototrial/circuit/basic/esp32.sch

## KiCad design prototrial/circuit/basic/esp32.sch (2022-03-24)

Schematic: esp32.sch

Parts:
Brd1: SSD1306
D1: LED
J-PROG1: Conn_01x06_Male
R-BTN1, R-BTN2, R-BTN3: 10K
R-ESP1, R-ESP2: 10K
R-LED1: 330
R-OLED1, R-OLED2: 10K
R-UART1, R-UART2: 0
SW-BTN1, SW-BTN2, SW-BTN3: SW_Push
U1: ESP32-WROOM-32
U2: INMP441
