VibrasticLab/pikoakustik2/prototrial/circuit/basic/stm32.sch

## KiCad design prototrial/circuit/basic/stm32.sch (2022-03-31)

Schematic: stm32.sch

Parts:
C-VCAP1: 4.7uF
D-ANS-FALSE1: LED
D-ANS-TRUE1: LED
D-BTN1, D-BTN2, D-BTN3: LED
D-RUN1: LED
J-STM32-PROG1: Conn_01x05_Male
J-USB1: USB_B_Micro
L-DAC1, L-DAC2: 100uH
R-ANS1, R-ANS2, R-ANS3: 10K
R-DAC-EN1: 1M
R-DAC-GAIN1: 100K
R-LED-ANS1: 330
R-LED-BTN1: 330
R-LED-RUN1: 330
R-MMC1, R-MMC2, R-MMC3: 10K
R-RST1: 10K
R-USB1: 4k7
R-USB2, R-USB3: 68
SD1: MICRO-SD-CARD-SOCKET-9P_ST-TF-003A_; MPN ST-TF-003A
SW-ANS1, SW-ANS2, SW-ANS3: SW_Push
U3: STM32F401RETx; LQFP-64_10x10mm_P0.5mm
U4: MAX98357
