VibrasticLab/pikoakustik2/prototrial/circuit/basic/vreg.sch

## KiCad design prototrial/circuit/basic/vreg.sch (2022-02-14)

Schematic: vreg.sch

Parts:
C-VREG1, C-VREG2: C
D-VREG1: D
J-BATTERY1: Conn_01x02_Male
U5: AMS1117-3.3; SOT-223-3_TabPin2
