VibrasticLab/pikoakustik2/prototrial/circuit/esp32lcd/esp32lcd.sch

## KiCad design prototrial/circuit/esp32lcd/esp32lcd.sch (2022-03-15)

Schematic: esp32lcd.sch

Parts:
Brd1: SSD1306
D-RUN1: LED
J-INMP441A1, J-INMP441B1: Conn_01x03_Male
J-PROG1: Conn_01x06_Male
J-STM32: Conn_01x04_Male
R-BTN1, R-BTN2, R-BTN3: 10K
R-ESP-EN1, R-ESP-EN2: 10K
R-LED1: 330
R-OLED1, R-OLED2: 10K
R-UART1, R-UART2: 0
SW1, SW2, SW3: SW_Push
U1: ESP32-WROOM-32
