VibrasticLab/pikoakustik2/prototrial/circuit/esplcd/esplcd.sch

## KiCad design prototrial/circuit/esplcd/esplcd.sch (2022-01-25)

Schematic: esplcd.sch

Parts:
Brd1: SSD1306; 128x64OLED
J-PROG1: Conn_01x06_Male; PinHeader_1x06_P2.54mm_Vertical
J-STM32UART1: Conn_01x03_Male; Molex_KK-254_AE-6410-03A_1x03_P2.54mm_Vertical
R-PROG1, R-PROG2, R-PROG3, R-PROG4, R-PROG5: 10K; R_0805_2012Metric_Pad1.20x1.40mm_HandSolder
R-SW1, R-SW2, R-SW3: 10K; R_0805_2012Metric_Pad1.20x1.40mm_HandSolder
SW-PAGE1: SW_Push; SW_PUSH_6mm
SW-SEND1: SW_Push; SW_PUSH_6mm
SW-WIFI1: SW_Push; SW_PUSH_6mm
U1: ESP-12E
