VibrasticLab/pikoakustik2/actual/firmware/stm32-m4/piko/ht_btn.c

/**
 * @file    ht_btn.c
 * @brief   Button routine code.
 *
 * @addtogroup GPIO
 * @{
 */

#include <stdio.h>
#include <stdlib.h>

#include "ch.h"
#include "hal.h"

#include "chprintf.h"

#include "ht_config.h"

#include "ht_led.h"
#include "ht_btn.h"
#include "ht_audio.h"
#include "ht_metri.h"
#include "ht_console.h"

extern uint8_t mode_status;
extern uint8_t mode_step;
extern uint8_t mode_led;
extern uint8_t numresp;
extern uint8_t freq_count;

/**
 * @brief Mode button combination for entering next mode
 */
static uint8_t mode_btnA;

/**
 * @brief Mode button combination for entering next mode
 */
static uint8_t mode_btnB;

/**
 * @brief Mode button combination for entering next mode
 */
static uint8_t mode_btnC;

/**
 * @brief Reset Button function called by EXTI callback
 */
static void reset_ledbutton(void){
    mode_btnA=0;
    mode_btnB=0;
    mode_btnC=0;
    led_answer_off();
    led_result_off();
}

/**
 * @brief Callback function for entering Standby Mode
 */
static void exti_idle_cb(void){
    ht_commUSB_Msg("Entering Mode: Standby\r\n");

    reset_ledbutton();

    if(mode_led==LED_READY){
        mode_status=STT_STDBY;
        led_resultYES();
    }
}

/**
 * @brief Callback function for entering Check Save File Mode
 */
static void exti_stdby_cb(void){
    ht_commUSB_Msg("Entering Mode: Checking Save File\r\n");
    palSetPad(GPIOA, LED_RUN);

    mode_led=LED_CFILE;
    mode_status=STT_CFILE;

    reset_ledbutton();
}

/**************** ChibiOS/RT 20.3.x GPIO Interrupt **************/

/**
 * @brief Button answer A callback
 * @details Not called directly by any normal thread
 */
 static void btnA_cb(void *arg) {

  (void)arg;

  chSysLockFromISR();

    if(mode_status==STT_IDLE){
        led_answer_off();
        led_answerA();
        mode_btnA=1;

        ht_commUSB_Msg("Entering Mode: Setup\r\n");
        mode_status = STT_SETUP;
    }
    else if(mode_status==STT_READY){
        if(mode_btnA==0){
            if((mode_btnB==1)||(mode_btnC==1)){
                exti_idle_cb();
                mode_btnA=1;
            }
        }
    }
    else if(mode_status==STT_STDBY){
        if(mode_btnA==0){exti_stdby_cb();}
    }
    else if(mode_status==STT_METRI){
        if(mode_step==STEP_WAIT){
            numresp = BTN_ANS_A;
            mode_step = STEP_CHK;
        }
    }

  chSysUnlockFromISR();
}

/**
 * @brief Button answer B callback
 * @details Not called directly by any normal thread
 */
 static void btnB_cb(void *arg) {

  (void)arg;

  chSysLockFromISR();

    if(mode_status==STT_IDLE){
        led_answer_off();
        led_answerB();
        mode_btnB=1;

        ht_commUSB_Msg("Entering Mode: Setup\r\n");
        mode_status = STT_SETUP;
    }
    else if(mode_status==STT_READY){
        if(mode_btnB==0){
            if((mode_btnA==1)||(mode_btnC==1)){
                exti_idle_cb();
                mode_btnB=1;
            }
        }
    }
    else if(mode_status==STT_STDBY){
        if(mode_btnB==0){exti_stdby_cb();}
    }
    else if(mode_status==STT_METRI){
        if(mode_step==STEP_WAIT){
            numresp = BTN_ANS_B;
            mode_step = STEP_CHK;
        }
    }

  chSysUnlockFromISR();
}

/**
 * @brief Button answer C callback
 * @details Not called directly by any normal thread
 */
 static void btnC_cb(void *arg) {

  (void)arg;

  chSysLockFromISR();

    if(mode_status==STT_IDLE){
        led_answer_off();
        led_answerC();
        mode_btnC=1;

        ht_commUSB_Msg("Entering Mode: Setup\r\n");
        mode_status = STT_SETUP;
    }
    else if(mode_status==STT_READY){
        if(mode_btnC==0){
            if((mode_btnA==1)||(mode_btnB==1)){
                exti_idle_cb();
                mode_btnC=1;
            }
        }
    }
    else if(mode_status==STT_STDBY){
        if(mode_btnC==0){exti_stdby_cb();}
    }
    else if(mode_status==STT_METRI){
        if(mode_step==STEP_WAIT){
            numresp = BTN_ANS_C;
            mode_step = STEP_CHK;
        }
    }

  chSysUnlockFromISR();
}

/**************** ChibiOS/RT 17.6.x GPIO Interrupt **************/

#ifdef CH_17
/**
 * @brief Button answer EXTI A callback
 * @details Enumerated and not called directly by any normal thread
 */
static void extiAnsA(EXTDriver *extp, expchannel_t channel) {
    (void)extp;
    (void)channel;

    if(mode_status==STT_IDLE){
        led_answer_off();
        led_answerA();
        mode_btnA=1;

        ht_commUSB_Msg("Entering Mode: Setup\r\n");
        mode_status = STT_SETUP;
    }
    else if(mode_status==STT_READY){
        if(mode_btnA==0){
            if((mode_btnB==1)||(mode_btnC==1)){
                exti_idle_cb();
                mode_btnA=1;
            }
        }
    }
    else if(mode_status==STT_STDBY){
        if(mode_btnA==0){exti_stdby_cb();}
    }
    else if(mode_status==STT_METRI){
        if(mode_step==STEP_WAIT){
            numresp = BTN_ANS_A;
            mode_step = STEP_CHK;
        }
    }

    return;
}
#endif

#ifdef CH_17
/**
 * @brief Button answer EXTI B callback
 * @details Enumerated and not called directly by any normal thread
 */
static void extiAnsB(EXTDriver *extp, expchannel_t channel) {
    (void)extp;
    (void)channel;

    if(mode_status==STT_IDLE){
        led_answer_off();
        led_answerB();
        mode_btnB=1;

        ht_commUSB_Msg("Entering Mode: Setup\r\n");
        mode_status = STT_SETUP;
    }
    else if(mode_status==STT_READY){
        if(mode_btnB==0){
            if((mode_btnA==1)||(mode_btnC==1)){
                exti_idle_cb();
                mode_btnB=1;
            }
        }
    }
    else if(mode_status==STT_STDBY){
        if(mode_btnB==0){exti_stdby_cb();}
    }
    else if(mode_status==STT_METRI){
        if(mode_step==STEP_WAIT){
            numresp = BTN_ANS_B;
            mode_step = STEP_CHK;
        }
    }

    return;
}
#endif

#ifdef CH_17
/**
 * @brief Button answer EXTI C callback
 * @details Enumerated and not called directly by any normal thread
 */
static void extiAnsC(EXTDriver *extp, expchannel_t channel) {
    (void)extp;
    (void)channel;

    if(mode_status==STT_IDLE){
        led_answer_off();
        led_answerC();
        mode_btnC=1;

        ht_commUSB_Msg("Entering Mode: Setup\r\n");
        mode_status = STT_SETUP;
    }
    else if(mode_status==STT_READY){
        if(mode_btnC==0){
            if((mode_btnA==1)||(mode_btnB==1)){
                exti_idle_cb();
                mode_btnC=1;
            }
        }
    }
    else if(mode_status==STT_STDBY){
        if(mode_btnC==0){exti_stdby_cb();}
    }
    else if(mode_status==STT_METRI){
        if(mode_step==STEP_WAIT){
            numresp = BTN_ANS_C;
            mode_step = STEP_CHK;
        }
    }

    return;
}
#endif

/*******************************************/

#ifdef CH_17
/**
 * @brief External Interrupt Channel Config
 */
static const EXTConfig extcfg = {
  {
    {EXT_CH_MODE_FALLING_EDGE  | EXT_MODE_GPIOC, extiAnsA}, //0
    {EXT_CH_MODE_FALLING_EDGE  | EXT_MODE_GPIOC, extiAnsB}, //1
    {EXT_CH_MODE_FALLING_EDGE  | EXT_MODE_GPIOC, extiAnsC}, //2
    {EXT_CH_MODE_DISABLED, NULL}, //3
    {EXT_CH_MODE_DISABLED, NULL}, //4
    {EXT_CH_MODE_DISABLED, NULL}, //5
    {EXT_CH_MODE_DISABLED, NULL}, //6
    {EXT_CH_MODE_DISABLED, NULL}, //7
    {EXT_CH_MODE_DISABLED, NULL}, //8
    {EXT_CH_MODE_DISABLED, NULL}, //9
    {EXT_CH_MODE_DISABLED, NULL}, //10
    {EXT_CH_MODE_DISABLED, NULL}, //11
    {EXT_CH_MODE_DISABLED, NULL}, //12
    {EXT_CH_MODE_DISABLED, NULL}, //13
    {EXT_CH_MODE_DISABLED, NULL}, //14
    {EXT_CH_MODE_DISABLED, NULL}, //15
    {EXT_CH_MODE_DISABLED, NULL}, //16
    {EXT_CH_MODE_DISABLED, NULL}, //17
    {EXT_CH_MODE_DISABLED, NULL}, //18
    {EXT_CH_MODE_DISABLED, NULL}, //19
    {EXT_CH_MODE_DISABLED, NULL}, //20
    {EXT_CH_MODE_DISABLED, NULL}, //21
    {EXT_CH_MODE_DISABLED, NULL}  //22
  }
};
#endif

/*******************************************/

void ht_btn_Init(void){
	palSetPadMode(GPIOC, 0, PAL_MODE_INPUT_PULLUP);
	palSetPadMode(GPIOC, 1, PAL_MODE_INPUT_PULLUP);
	palSetPadMode(GPIOC, 2, PAL_MODE_INPUT_PULLUP);

#ifdef CH_20
	palEnableLineEvent(PAL_LINE(GPIOC, 0), PAL_EVENT_MODE_FALLING_EDGE);
	palSetLineCallback(PAL_LINE(GPIOC, 0), btnA_cb, NULL);

	palEnableLineEvent(PAL_LINE(GPIOC, 1), PAL_EVENT_MODE_FALLING_EDGE);
	palSetLineCallback(PAL_LINE(GPIOC, 1), btnB_cb, NULL);

	palEnableLineEvent(PAL_LINE(GPIOC, 2), PAL_EVENT_MODE_FALLING_EDGE);
	palSetLineCallback(PAL_LINE(GPIOC, 2), btnC_cb, NULL);
#endif

#ifdef CH_17
    extStart(&EXTD1, &extcfg);
    extChannelEnable(&EXTD1, 0);
    extChannelEnable(&EXTD1, 1);
    extChannelEnable(&EXTD1, 2);
#endif

    mode_btnA=0;
    mode_btnB=0;
    mode_btnC=0;
}

/** @} */
