VibrasticLab/pikoakustik2/actual/firmware/esp32/main/my_wifista.c

/**
 * @file my_wifista.c
 * @brief WIFI Station code
 *
 * @addtogroup WIFI
 * @{
 */

#include "my_includes.h"

extern uint8_t my_wifi_type;

/**
 * @brief STA WIFI SSID
 *
 */
#define EXAMPLE_ESP_WIFI_SSID      "AchmadiWifi"

/**
 * @brief STA WIFI Passwrod
 *
 */
#define EXAMPLE_ESP_WIFI_PASS      "stardust"

/**
 * @brief STA WIFI Connection Trial
 *
 */
#define EXAMPLE_ESP_MAXIMUM_RETRY  5

static EventGroupHandle_t s_wifi_event_group;

#define WIFI_CONNECTED_BIT BIT0
#define WIFI_FAIL_BIT      BIT1

static const char *TAG = "wifiSTA";

static int s_retry_num = 0;

static void event_handler(void* arg, esp_event_base_t event_base, int32_t event_id, void* event_data){
    if(event_base == WIFI_EVENT && event_id == WIFI_EVENT_STA_START){
        esp_wifi_connect();
    }
    else if (event_base == WIFI_EVENT && event_id == WIFI_EVENT_STA_DISCONNECTED) {
        if(s_retry_num < EXAMPLE_ESP_MAXIMUM_RETRY){
            esp_wifi_connect();
            s_retry_num++;
            ESP_LOGI(TAG, "retry to connect");
        }
        else{
            xEventGroupSetBits(s_wifi_event_group, WIFI_FAIL_BIT);
        }
    }
    else if (event_base == IP_EVENT && event_id == IP_EVENT_STA_GOT_IP) {
        ip_event_got_ip_t* event = (ip_event_got_ip_t*) event_data;
        ESP_LOGI(TAG, "got ip:" IPSTR, IP2STR(&event->ip_info.ip));
        s_retry_num = 0;
        xEventGroupSetBits(s_wifi_event_group, WIFI_CONNECTED_BIT);
    }
}

void my_wifiInitSTA(void){
    s_wifi_event_group = xEventGroupCreate();

    ESP_ERROR_CHECK(esp_netif_init());

    ESP_ERROR_CHECK(esp_event_loop_create_default());
    esp_netif_create_default_wifi_sta();

    wifi_init_config_t cfg = WIFI_INIT_CONFIG_DEFAULT();
    ESP_ERROR_CHECK(esp_wifi_init(&cfg));

    esp_event_handler_instance_t instance_any_id;
    esp_event_handler_instance_t instance_got_ip;
    ESP_ERROR_CHECK(esp_event_handler_instance_register(WIFI_EVENT,
                                                        ESP_EVENT_ANY_ID,
                                                        &event_handler,
                                                        NULL,
                                                        &instance_any_id));
    ESP_ERROR_CHECK(esp_event_handler_instance_register(IP_EVENT,
                                                        IP_EVENT_STA_GOT_IP,
                                                        &event_handler,
                                                        NULL,
                                                        &instance_got_ip));

    wifi_config_t wifi_config = {
        .sta = {
            .ssid = EXAMPLE_ESP_WIFI_SSID,
            .password = EXAMPLE_ESP_WIFI_PASS,
            /* Setting a password implies station will connect to all security modes including WEP/WPA.
             * However these modes are deprecated and not advisable to be used. Incase your Access point
             * doesn't support WPA2, these mode can be enabled by commenting below line */
	     .threshold.authmode = WIFI_AUTH_WPA2_PSK,

            .pmf_cfg = {
                .capable = true,
                .required = false
            },
        },
    };

    ESP_ERROR_CHECK(esp_wifi_set_mode(WIFI_MODE_STA) );
    ESP_ERROR_CHECK(esp_wifi_set_config(WIFI_IF_STA, &wifi_config) );
    ESP_ERROR_CHECK(esp_wifi_start() );

    ESP_LOGI(TAG, "wifi station finished.");

    /* Waiting until either the connection is established (WIFI_CONNECTED_BIT) or connection failed for the maximum
     * number of re-tries (WIFI_FAIL_BIT). The bits are set by event_handler() (see above) */
    EventBits_t bits = xEventGroupWaitBits(s_wifi_event_group,
            WIFI_CONNECTED_BIT | WIFI_FAIL_BIT,
            pdFALSE,
            pdFALSE,
            portMAX_DELAY);

    /* xEventGroupWaitBits() returns the bits before the call returned, hence we can test which event actually
     * happened. */
    if (bits & WIFI_CONNECTED_BIT) {
        ESP_LOGI(TAG, "connected to ap SSID:%s password:%s",
                 EXAMPLE_ESP_WIFI_SSID, EXAMPLE_ESP_WIFI_PASS);

        my_wifi_type = WIFI_TYPE_STA;
#if MY_USE_HTTPD
 #if MY_HTTP_ON_WIFISTA  
        if(my_wifi_type==WIFI_TYPE_STA) my_httpdInit();
 #endif
#endif
    } else if (bits & WIFI_FAIL_BIT) {
        ESP_LOGI(TAG, "Failed to connect to SSID:%s, password:%s",
                 EXAMPLE_ESP_WIFI_SSID, EXAMPLE_ESP_WIFI_PASS);
    } else {
        ESP_LOGE(TAG, "UNEXPECTED EVENT");
    }
}

 /** @} */
