VibrasticLab/pikoakustik2/actual/firmware/stm32-m4/piko/ht_pta.h

/**
 * @file    ht_pta.h
 * @brief   Audiometri PTA header.
 *
 * @addtogroup Audiometri
 * @{
 */

#ifndef HT_PTA_H
#define HT_PTA_H

/**
 * @brief JSON Token Size
 * @details Bigger than this value will result variable overflow
 */
#define JSON_TOKEN_SIZE 512

/**
 * @brief Calibration Array Selection macro
 */
#define CALIBRATION_ARRAY  cal_JBL_RETSPL2

/**
 * @brief ht_ptaParse
 * @param[in] char JSON Record string
 * @return int JSON Token Number
 */
int ht_ptaParse(char *jsonString);

/**
 * @brief ht_ptaParse
 * @param[in] int JSON Token Number
 * @param[in] char JSON Record string
 */
void ht_ptaLoadArray(int id, char *jsonString);

/**
 * @brief Get final PTA Comma Separation Value
 */
void ht_ptaFinalCSV(uint16_t fnum, char *jsonPTA);

#endif // HT_PTA_H

/** @} */
