VibrasticLab/pikoakustik2/actual/firmware/esp32/main/my_pagepta.h

/**
 * @file my_pagepta.h
 * @brief PTA Display header
 *
 * @addtogroup LCD
 * @{
 */

#ifndef MY_PAGEPTA_H
#define MY_PAGEPTA_H

void my_pagePta(void);
void my_ptaArrayReset(void);
void my_ptaArrayLoad(char *csvArray);

#endif // MY_PAGEPTA_H

/** @} */
