VibrasticLab/pikoakustik2/actual/firmware/esp32/main/my_wifiap.h

/**
 * @file my_wifiap.h
 * @brief WIFI AP header
 *
 * @addtogroup WIFI
 * @{
 */

#ifndef MY_WIFI_H
#define MY_WIFI_H

#define WIFI_TYPE_OFF 0
#define WIFI_TYPE_AP  1
#define WIFI_TYPE_STA 2

void my_wifiInitAP(void);

#endif // MY_WIFI_H

/** @} */
