VibrasticLab/pikoakustik2/actual/firmware/esp32/main/my_pageplot.h

/**
 * @file my_pageplot.h
 * @brief Page Plot header
 *
 * @addtogroup LCD
 * @{
 */

#ifndef MY_PAGEPLOT_H
#define MY_PAGEPLOT_H

void my_pagePlot(void);
void my_pagePlot_demo(void);

#endif // MY_PAGEPLOT_H

/** @} */
