VibrasticLab/pikoakustik2/actual/firmware/esp32/main/my_pagefile.h

/**
 * @file my_pagefile.h
 * @brief Page File header
 *
 * @addtogroup LCD
 * @{
 */

#ifndef MY_PAGEFILE_H
#define MY_PAGEFILE_H

void my_pageFile(void);
void my_pageFile_demo(void);

#endif // MY_PAGEFILE_H

/** @} */
