VibrasticLab/pikoakustik2/actual/firmware/esp32/main/my_olcd.h

/**
 * @file my_olcd.h
 * @brief Basic LCD Draw header
 *
 * @addtogroup OLCD
 * @{
 */

#ifndef MY_OLCD_H
#define MY_OLCD_H

void my_olcdtest_img(void);
void my_olcdtest_text(void);
void my_register_oled(void);

#endif // MY_OLCD_H
