VibrasticLab/pikoakustik2/actual/firmware/esp32/main/my_cmd.h

/**
 * @file my_cmd.h
 * @brief Console commands header
 *
 * @addtogroup Console
 * @{
 */

#ifndef _MY_CMD_H_
#define _MY_CMD_H_

/**
 * @brief Register all basic commands
 *
 */
void my_registerCommands(void);

#endif

/** @} */
