VibrasticLab/pikoakustik2/actual/firmware/esp32/main/my_nvs.c

/**
 * @file my_nvs.c
 * @brief NVS source
 *
 * @addtogroup Main
 * @{
 */

#include "my_includes.h"

void my_nvsInit(void){
    esp_err_t ret = nvs_flash_init();
    if (ret == ESP_ERR_NVS_NO_FREE_PAGES || ret == ESP_ERR_NVS_NEW_VERSION_FOUND) {
      ESP_ERROR_CHECK(nvs_flash_erase());
      ret = nvs_flash_init();
    }
    ESP_ERROR_CHECK(ret);
}

/** @} */
