VibrasticLab/pikoakustik2/actual/firmware/esp32/main/my_nvs.h

/**
 * @file my_nvs.h
 * @brief NVS header
 *
 * @addtogroup Main
 * @{
 */

#ifndef _MY_NVS_H_
#define _MY_NVS_H_

/**
 * @brief Initialize NVS subsystem
 *
 */
void my_nvsInit(void);

#endif

/** @} */
