VibrasticLab/pikoakustik2/actual/firmware/stm32-m4/piko/ht_usb.h

/**
 * @file    ht_usb.h
 * @brief   USB-CDC header.
 *
 * @addtogroup Console
 * @{
 */

#ifndef HT_USB_H
#define HT_USB_H

#ifdef ST_F303RC
#define usb_lld_connect_bus(usbp)
#define usb_lld_disconnect_bus(usbp)
#endif

extern const USBConfig usbcfg;
extern SerialUSBConfig serusbcfg;
extern SerialUSBDriver SDU1;

#endif // HT_USB_H

/** @} */
