VibrasticLab/pikoakustik2/prototrial/firmware/esp32/main/my_shell.c

/**
 * @file my_shell.c
 * @brief UART Shell source
 *
 * @addtogroup Console
 * @{
 */

#include "my_includes.h"

#if UART_USE_PROMPT
const char* prompt = "esp32> ";
#else
const char* prompt = "";
#endif

/**
 * @brief UART Console Start
 *
 */
static void consoleInit(void){
    fflush(stdout);
    fsync(fileno(stdout));
    setvbuf(stdin, NULL,_IONBF, 0);

    esp_vfs_dev_uart_port_set_rx_line_endings(UART_NUM_0, ESP_LINE_ENDINGS_CR);
    esp_vfs_dev_uart_port_set_tx_line_endings(UART_NUM_0, ESP_LINE_ENDINGS_CRLF);

    const uart_config_t uartConf = {
        .baud_rate = UART_BAUDRATE,
        .data_bits = UART_DATA_8_BITS,
        .parity = UART_PARITY_DISABLE,
        .stop_bits = UART_STOP_BITS_1,
        .source_clk = UART_SCLK_REF_TICK,
    };

    ESP_ERROR_CHECK(uart_driver_install(UART_NUM_0, UART_BUFF_SIZE, 0, 0, NULL, 0));
    ESP_ERROR_CHECK(uart_param_config(UART_NUM_0, &uartConf));
    esp_vfs_dev_uart_use_driver(UART_NUM_0);

    const esp_console_config_t consoleConf = {
        .max_cmdline_args = 8,
        .max_cmdline_length = 256,
    };

    esp_console_init(&consoleConf);

    linenoiseAllowEmpty(true);
    linenoiseHistorySetMaxLen(100);
}

/**
 * @brief UART Shell start
 *
 */
void shellInit(void){
    consoleInit();
    esp_console_register_help_command();

    registerCommands();

#if UART_TO_STM32
    registerSTM32Messages();
    askingSTM32Init();
#endif

    printf("System Configured\n");

    /* always use Dumb Mode to disable echo feature */
    linenoiseSetDumbMode(1);
}

/**
 * @brief UART Shell loop
 *
 * @return int Execution status
 */
int shellLoop(void){
    char* line = linenoise(prompt);
    if(line==NULL){
        return 1;
    }

    if(strlen(line)>0){
        linenoiseHistoryAdd(line);
    }

    int ret;
#if UART_NO_ERROR_MSG
    esp_console_run(line, &ret);
#else
    esp_err_t err = esp_console_run(line, &ret);

    if (err == ESP_ERR_NOT_FOUND) {
        printf("Unrecognized command\n");
    } else if (err == ESP_ERR_INVALID_ARG) {
        printf("Invalid command arguments\n");
    } else if (err == ESP_OK && ret != ESP_OK) {
        printf("Command returned non-zero error code: 0x%x (%s)\n", ret, esp_err_to_name(ret));
    } else if (err != ESP_OK) {
        printf("Internal error: %s\n", esp_err_to_name(err));
    }
#endif

    /* linenoise allocates line buffer on the heap, so need to free it */
    linenoiseFree(line);
    return 0;
}

/** @} */
