VibrasticLab/pikoakustik2/prototrial/firmware/esp32/main/myconfig.h

/**
 * @file    myconfig.h
 * @brief   Global config header.
 *
 * @addtogroup Main
 * @{
 */

#ifndef _MY_CONFIG_H_
#define _MY_CONFIG_H_

/**
 * @brief LED Blink pin
 *
 */
#define BLINK_GPIO  2

/**
 * @brief LED Blink delay in ms
 *
 */
#define BLINK_DELAY 100

/**
 * @brief Whether use UART0 connected to STM32 chip or not
 * @warning If choose not and UART0 used for debugging,
 *          then STM32 must be hold on reset!
 */
#define UART_TO_STM32   FALSE

/**
 * @brief UART baudrate value
 */
#define UART_BAUDRATE   38400

/**
 * @brief Whether Shell use prompt
 *
 */
#define UART_USE_PROMPT 0

/**
 * @brief Disable any unsuccesful command responses
 *
 */
#define UART_NO_ERROR_MSG 1

/**
 * @brief Use Console in dumb mode
 *
 */
#define CONSOLE_DUMB

#endif

/** @} */
