VibrasticLab/pikoakustik2/prototrial/firmware/esp32/main/lcd_draw.h

/**
 * @file lcd_draw.h
 * @brief Basic LCD Draw header
 *
 * @addtogroup LCD
 * @{
 */

#ifndef LCD_DRAW_H
#define LCD_DRAW_H

void test_olcd_img(void);
void register_oled(void);

#endif // LCD_DRAW_H

/** @} */
