VibrasticLab/pikoakustik2/prototrial/firmware/esp32/main/page_files.h

/**
 * @file page_files.h
 * @brief Page Files header
 * 
 * @addtogroup LCD
 * @{
 */

#ifndef PAGE_FILES_H
#define PAGE_FILES_H

void page_files(void);
void page_files_demo(void);

#endif // PAGE_FILES_H

/** @} */
