VibrasticLab/pikoakustik2/prototrial/firmware/esp32/main/page_plot.h

/**
 * @file page_plot.h
 * @brief Page Plot header
 * 
 * @addtogroup LCD
 * @{
 */

#ifndef PAGE_PLOT_H
#define PAGE_PLOT_H

void page_plot(void);
void page_plot_demo(void);

#endif // PAGE_PLOT_H

/** @} */
