VibrasticLab/pikoakustik2/prototrial/firmware/esp8266/main/my_console.c

#include "my_includes.h"

#ifdef CONSOLE_NOPROMPT
 const char* prompt = "";
#else
 const char* prompt = "esp8266> ";
#endif


static void initialize_nvs()
{
    esp_err_t err = nvs_flash_init();
    if (err == ESP_ERR_NVS_NO_FREE_PAGES) {
        ESP_ERROR_CHECK( nvs_flash_erase() );
        err = nvs_flash_init();
    }
    ESP_ERROR_CHECK(err);
}

static void initialize_console(){
    initialize_nvs();

    setvbuf(stdin, NULL, _IONBF, 0);

    esp_vfs_dev_uart_set_rx_line_endings(ESP_LINE_ENDINGS_CR);
    esp_vfs_dev_uart_set_tx_line_endings(ESP_LINE_ENDINGS_CRLF);

    uart_config_t uart_config = {
            .baud_rate = CONFIG_ESP_CONSOLE_UART_BAUDRATE,
            .data_bits = UART_DATA_8_BITS,
            .parity = UART_PARITY_DISABLE,
            .stop_bits = UART_STOP_BITS_1,
    };

    ESP_ERROR_CHECK(uart_param_config(CONFIG_ESP_CONSOLE_UART_NUM, &uart_config));
    ESP_ERROR_CHECK(uart_driver_install(CONFIG_ESP_CONSOLE_UART_NUM,256, 0, 0, NULL, 0) );

    esp_vfs_dev_uart_use_driver(CONFIG_ESP_CONSOLE_UART_NUM);

    esp_console_config_t console_config = {
            .max_cmdline_args = 8,
            .max_cmdline_length = 256,
    };
    ESP_ERROR_CHECK(esp_console_init(&console_config));

    //linenoiseAllowEmpty(true);
    linenoiseHistorySetMaxLen(100);
}

void start_console(void){
    initialize_nvs();
    initialize_console();

    esp_console_register_help_command();
    register_system();

#ifdef CONSOLE_DUMB
    printf("\n"
           "This is an example of ESP-IDF console component.\n"
           "Type 'help' to get the list of commands.\n");
    linenoiseSetDumbMode(1);
#else
    printf("\n"
           "This is an example of ESP-IDF console component.\n"
           "Type 'help' to get the list of commands.\n"
           "Use UP/DOWN arrows to navigate through command history.\n"
           "Press TAB when typing command name to auto-complete.\n");

    int probe_status = linenoiseProbe();
    if (probe_status) {
        printf("\n"
               "Your terminal application does not support escape sequences.\n"
               "Line editing and history features are disabled.\n"
               "On Windows, try using Putty instead.\n");
        linenoiseSetDumbMode(1);
    }
#endif
}

int loop_console(void){
    char* line = linenoise(prompt);
    if(line==NULL) return 1;

#ifdef CONSOLE_DUMB
#else
    if(strlen(line)>0) linenoiseHistoryAdd(line);
#endif
    
    int ret;
    esp_err_t err = esp_console_run(line, &ret);
    if (err == ESP_ERR_NOT_FOUND) {
        printf("Unrecognized command\n");
    } else if (err == ESP_ERR_INVALID_ARG) {
        printf("Invalid command\n");
    } else if (err == ESP_OK && ret != ESP_OK) {
        printf("Command returned non-zero error code: 0x%x (%s)\n", ret, esp_err_to_name(err));
    } else if (err != ESP_OK) {
        printf("Internal error: %s\n", esp_err_to_name(err));
    }

    linenoiseFree(line);
    return 0;
}
