VibrasticLab/pikoakustik2/(commit log)

2022-01-13 OLED i2c implement
2022-01-13 OLED I2C implementation
2022-01-13 OLED I2C Bus working
2022-01-13 I2C address
2022-01-21 circuit esplcd proto
    [esplcd.kicad_pcb, esplcd.sch]
2022-01-21 esp lcd draft
    [esplcd.kicad_pcb, esplcd.sch]
2022-01-25 page plot
    [esplcd.sch]
2022-01-25 send page
    [esplcd.sch]
2022-01-25 paging jalan
    [esplcd.kicad_pcb, esplcd.sch]
2022-02-02 start reworking on ESP32
    [lcd_draw.c, lcd_draw.h, main.c, my_cmd.c, my_cmd.h, my_includes.h, my_led.c, my_led.h]
2022-02-10 progress ESP32
    [esp32lcd.sch]
2022-02-12 skematik only
    [esplcd.kicad_pcb]
2022-02-14 stm32 part
    [stm32metri.sch]
2022-02-14 multi sheet schematic
    [basic.sch, esp32.sch, stm32.sch]
2022-02-14 All Part
    [basic.sch, esp32.sch, stm32.sch, vreg.sch]
2022-02-14 Hide Reference Lables
    [esp32.sch, stm32.sch, vreg.sch]
2022-02-14 Still confuse on better looks schematics
    [esp32.sch]
2022-02-14 RX/TX resistor
    [esp32.sch]
2022-02-15 Mic result seems weird
    [esp32.sch, esp32lcd.sch]
2022-02-15 I2S 16bit seems working
    [esp32.sch]
2022-02-23 rework basic schematic into Altium
    [esp32.SchDoc, pikobasic.PrjPcb, pikobasic.SchDoc]
2022-02-23 Altium seems as fun as KiCAD
    [esp32.SchDoc, pikobasic.PrjPcb, pikobasic.SchDoc]
2022-02-23 try re-drafting to Altium
    [esp32.SchDoc, esp32.sch, esp32lcd.sch, pikobasic.PrjPcb, pikobasic.SchDoc, stm32.SchDoc, vreg.SchDoc]
2022-02-28 STM32F407 Doc
2022-03-07 update STM32
    [pikobasic.PrjPcb, stm32.SchDoc]
2022-03-07 Altium Basic
    [pikobasic.PrjPcb, stm32.SchDoc]
2022-03-07 Altium Basic All
    [stm32.SchDoc]
2022-03-08 F303 alternatif
    [esp32.SchDoc, pikobasic_f3.PrjPcb, pikobasic_f3.SchDoc, stm32.SchDoc, vreg.SchDoc]
2022-03-15 pin button remap
    [esp32.SchDoc, esp32.sch, esp32lcd.sch, pikobasic_f3.PrjPcb, stm32.SchDoc]
2022-03-20 interrupt remap
2022-03-23 iot data GET failed
    [data_send.c, main.c, my_exti.c, my_includes.h, my_wifi.c, my_wifista.c]
2022-03-23 GET socket run
2022-03-24 disable all log output
    [esp32.SchDoc, esp32.sch]
2022-03-25 ESP32 project files
2022-03-26 base STM32
2022-03-26 prepare for UART-UART data exchange
2022-03-28 trying to UART-UART at 38400
2022-03-28 first UART-UART message flow
2022-03-28 seems CTS/DTS still influence ESP32
2022-03-31 R-GAIN to VDD only
    [stm32.SchDoc, stm32.sch]
2022-04-01 Virt Test failed even without MMC
    [ht_config.h, ht_metri.c]
2022-04-01 reimplementation done for STM32F401RE
2022-04-01 Complete JSON failed on server
    [data_send.c, my_shell.c]
2022-04-01 ESP32 connect option to STM32
2022-04-02 JSON data failed spectacularly
    [ht_console.c, ht_mmc.c]
2022-04-02 drop tester and replace with iot key
    [ht_config.h, ht_console.c, ht_mmc.c]
2022-04-03 STM32 disable all metri debug message
2022-04-04 MMC file bomb bug
    [ht_metri.c, ht_mmc.c]
2022-04-04 Thread heap size max at 2048
2022-04-04 Working with some bugs
    [audiogram.cpp, ht_console.c]
2022-04-04 stm32 program script
2022-04-05 STM32 tone min max
2022-04-06 stm32 milestone
2022-04-08 measurement data salvage
    [Pengujian Audiometry Hari 1.xlsx, Pengujian Audiometry Hari 2.xlsx, Pengujian Audiometry Hari 3.xlsx, Pengujian Audiometry.xlsx, Tanpa unit (Bose).xlsx, Tanpa unit (Miniso).xlsx, Tanpa unit tanpa headphone.xlsx]
2022-04-20 update relay audio
    [stm32.SchDoc]
2022-04-20 prepare new redesign
    [stm32.SchDoc]
2022-04-20 redesign diagram
    [Diagram_Power.SchDoc, pikobasic_new.PrjPcb]
2022-04-21 power diagram
    [Diagram_Power.SchDoc, pikobasic_new.PrjPcb]
2022-05-05 New PCB Altium
    [esp32.SchDoc, overall.SchDoc, pikobasic_new.PrjPcb, stm32.SchDoc, vreg.SchDoc]
2022-05-05 remove unused
    [esp32.SchDoc, pikobasic_f3.PrjPcb, pikobasic_f3.SchDoc, stm32.SchDoc, vreg.SchDoc]
2022-05-05 update PCB Power
    [Diagram_Power.SchDoc, Diagram_Signal.SchDoc, esp32.SchDoc, overall.SchDoc, pikobasic_new.PrjPcb, stm32.SchDoc, vreg.SchDoc]
2022-05-06 upate PCB
    [Diagram_Power.SchDoc, esp32.SchDoc, pikobasic_new.PrjPcb, stm32.SchDoc]
2022-05-06 update PCB P3
    [Diagram_Signal.SchDoc, esp32.SchDoc, pikobasic_new.PrjPcb, stm32.SchDoc]
2022-05-06 summary update PCB
    [Diagram_Power.SchDoc, esp32.SchDoc, overall.SchDoc]
2022-05-13 update PCB
    [DAC.SchDoc, Diagram_Power.SchDoc, Diagram_Signal.SchDoc, ESP32_EDITED.SchDoc, POWER_RAIL.SchDoc, STM32_EDITED.SchDoc, esp32.SchDoc, pikobasic_new.PrjPcb]
2022-06-04 start actual on f303rc
    [DAC.SchDoc]
2022-06-10 I2S pin choice for F303RC and F401RE
2022-06-10 MMC SPI changes on 20.3
2022-06-10 SPI MMC working
2022-06-12 button compileable
2022-06-12 F303RC OK
    [Diagram_Signal.SchDoc]
2022-06-12 F401RE SPI MMC failed
    [board.h, halconf.h, ht_mmc.c, mcuconf.h]
2022-06-12 F303RC PCB is too damaged
    [ht_mmc.c]
2022-06-12 Why ChibiOS/RT so buggy?
    [mcuconf.h]
2022-06-15 guarding session start if MMC fail
    [ht_btn.c, ht_exti.c]
2022-06-21 Improving the MMC
    [Diagram_Signal.SchDoc]
2022-06-22 MMC disk formatting not work
    [ht_config.h, ht_mmc.c, ht_mmc.h]
2022-06-22 update Altium design
    [Diagram_Power.SchDoc, Diagram_Signal.SchDoc, ESP32_EDITED.SchDoc, STM32_EDITED.SchDoc]
2022-06-29 ESP32 rewriting
    [Diagram_Signal.SchDoc]
2022-06-29 ESP32 UART0 rewriting
2022-06-29 use Silent UART
2022-06-29 UART0 OK
2022-06-29 ESP32 use UART1
2022-06-29 ESP32 UART-1 supressed messages works
2022-06-30 ESP32 rewrite progress
    [ESP32_EDITED.SchDoc, STM32_EDITED.SchDoc]
2022-07-05 progress PCB
    [Diagram_Signal.SchDoc, pikobasic_new.PrjPcb]
2022-07-05 ESP32 WiFi
2022-07-07 progress di Xirca
2022-07-07 new line on ESP32 cmds
2022-07-08 Home Page Display ESP32
2022-07-08 Adjust STM32 I2S DMA array size
2022-07-08 Adjust STM32 I2S DMA array
2022-07-08 ADC ESP32
2022-07-27 STM32 Left/Right relay pin
    [pikobasic.PrjPcb]
2022-07-28 STM32 IO Status
2022-07-28 ESP32 Flash script
2022-07-28 Try ADC Battery on ESP32
2022-07-29 ESP32 UART Options
2022-07-29 ESP32 read adc battery
2022-07-29 ESP32 Battery ADC
2022-07-29 Page Button
2022-07-29 Re-Check UART on ESP32
2022-09-13 Revert back to P2 method
    [ht_config.h, ht_metri.c, ht_metri.h]
2022-10-02 ESP32 HTTPD
2022-10-02 ESP32 Main thread need 10ms delay
2022-10-02 Improving ESP32 (Wifi AP Interface)
2022-10-02 ESP32 TestData
2022-10-02 WiFi AP start on Button Action X
2022-10-03 Start building data exchange STM32-ESP32
2022-11-04 ESP32 Audiometri run progress
2022-11-04 STM32 Audiometri Progress
2022-11-10 STM32 use only record at the end method
2022-11-10 Serial ESP32 to STM32 failed
    [ht_console.c, ht_mmc.c, my_btn.c, my_btn.h]
2022-11-14 STM32 UART RX error
    [ht_config.h, ht_metri.c, main.c, my_config.h]
2022-11-23 Workaround Unsaved result Bug
    [ht_config.h, ht_metri.c]
2022-11-23 Workaround Wrong Answer Choice Bug
    [ht_metri.c]
2022-11-23 STM32 buffer save always overwrite
2022-11-25 Buffer Order File on STM32 Audiometri
2022-12-06 STM32 disable Log by default
2023-01-11 Tryto solve button input bug
    [ht_btn.h, ht_config.h, ht_metri.c, main.c]
2023-01-12 Revisi tombol STM32
2023-01-31 P3 in KiCAD
    [esp32.kicad_sch, skema_p3.kicad_sch]
2023-01-31 P3 in KiCAD Schematic
    [esp32.kicad_sch, skema_p3.kicad_sch]
2023-02-06 Update di Xirca
2023-04-07 STM32 UART Shell not work
2023-04-07 Resolved conflict on UART1 pins
    [ht_console.c]
2023-05-09 Update ESP32 Progs
2023-05-09 STM32 use QtCreator
2023-05-09 Start Working on Calibration routine
2023-05-10 Not Enough space on STM32 for JSMN Parser
2023-05-10 JSON Parser on ESP32
2023-05-11 PTA on STM32
2023-05-11 STM32 Console callback documentation
2023-05-11 Update ESP32
2023-05-11 ESP32 PTA
2023-05-15 Fix dual PTA command on UART
    [ht_console.c]
2023-07-06 Add 125Hz to Test Console
2023-07-10 Koleksi Data July 2023
    [1000Hz-L.csv, 1000Hz-R.csv, 125Hz-L.csv, 125Hz-R.csv, 2000Hz-L.csv, 2000Hz-R.csv, 250Hz-L.csv, 250Hz-R.csv]
2023-07-11 update on data records
    [1000Hz-R.csv, 125Hz-R.csv, 2000Hz-R.csv, 250Hz-R.csv, 4000Hz-R.csv, 500Hz-R.csv, 8000Hz-R.csv]
